andreili/STM32-PLC/TODO.txt

Hardware:
    1) Исправить разводку светодиодов RUN/STOP;
    2) Подключить сигнал CARD_DETECT к МК;
    3) Исправить посадочное место переключателя RUN/STOP;
    4)

Software:
    1) Перевести шину на аппаратный режим NSS;
    2) Переход в STOP:
        * Выставить флаг перехода в STOP;
        * Подождать завершения текущего цикла;
        * Подождать оконцания записи в NAND и SD;
        * Выставить флаг состояния STOP;
        * Ждать снятия сигнала STOP.
    3)
