andreili/STM32-PLC/(list of files, cad)

Other CAD files:
stlc/example/test.stl
stlc/example/prog.stl
