andreili/STM32-PLC/hardware/hw_cpu/hw_cpu.kicad_pcb

## KiCad design hardware/hw_cpu/hw_cpu.kicad_pcb (2017-12-27)

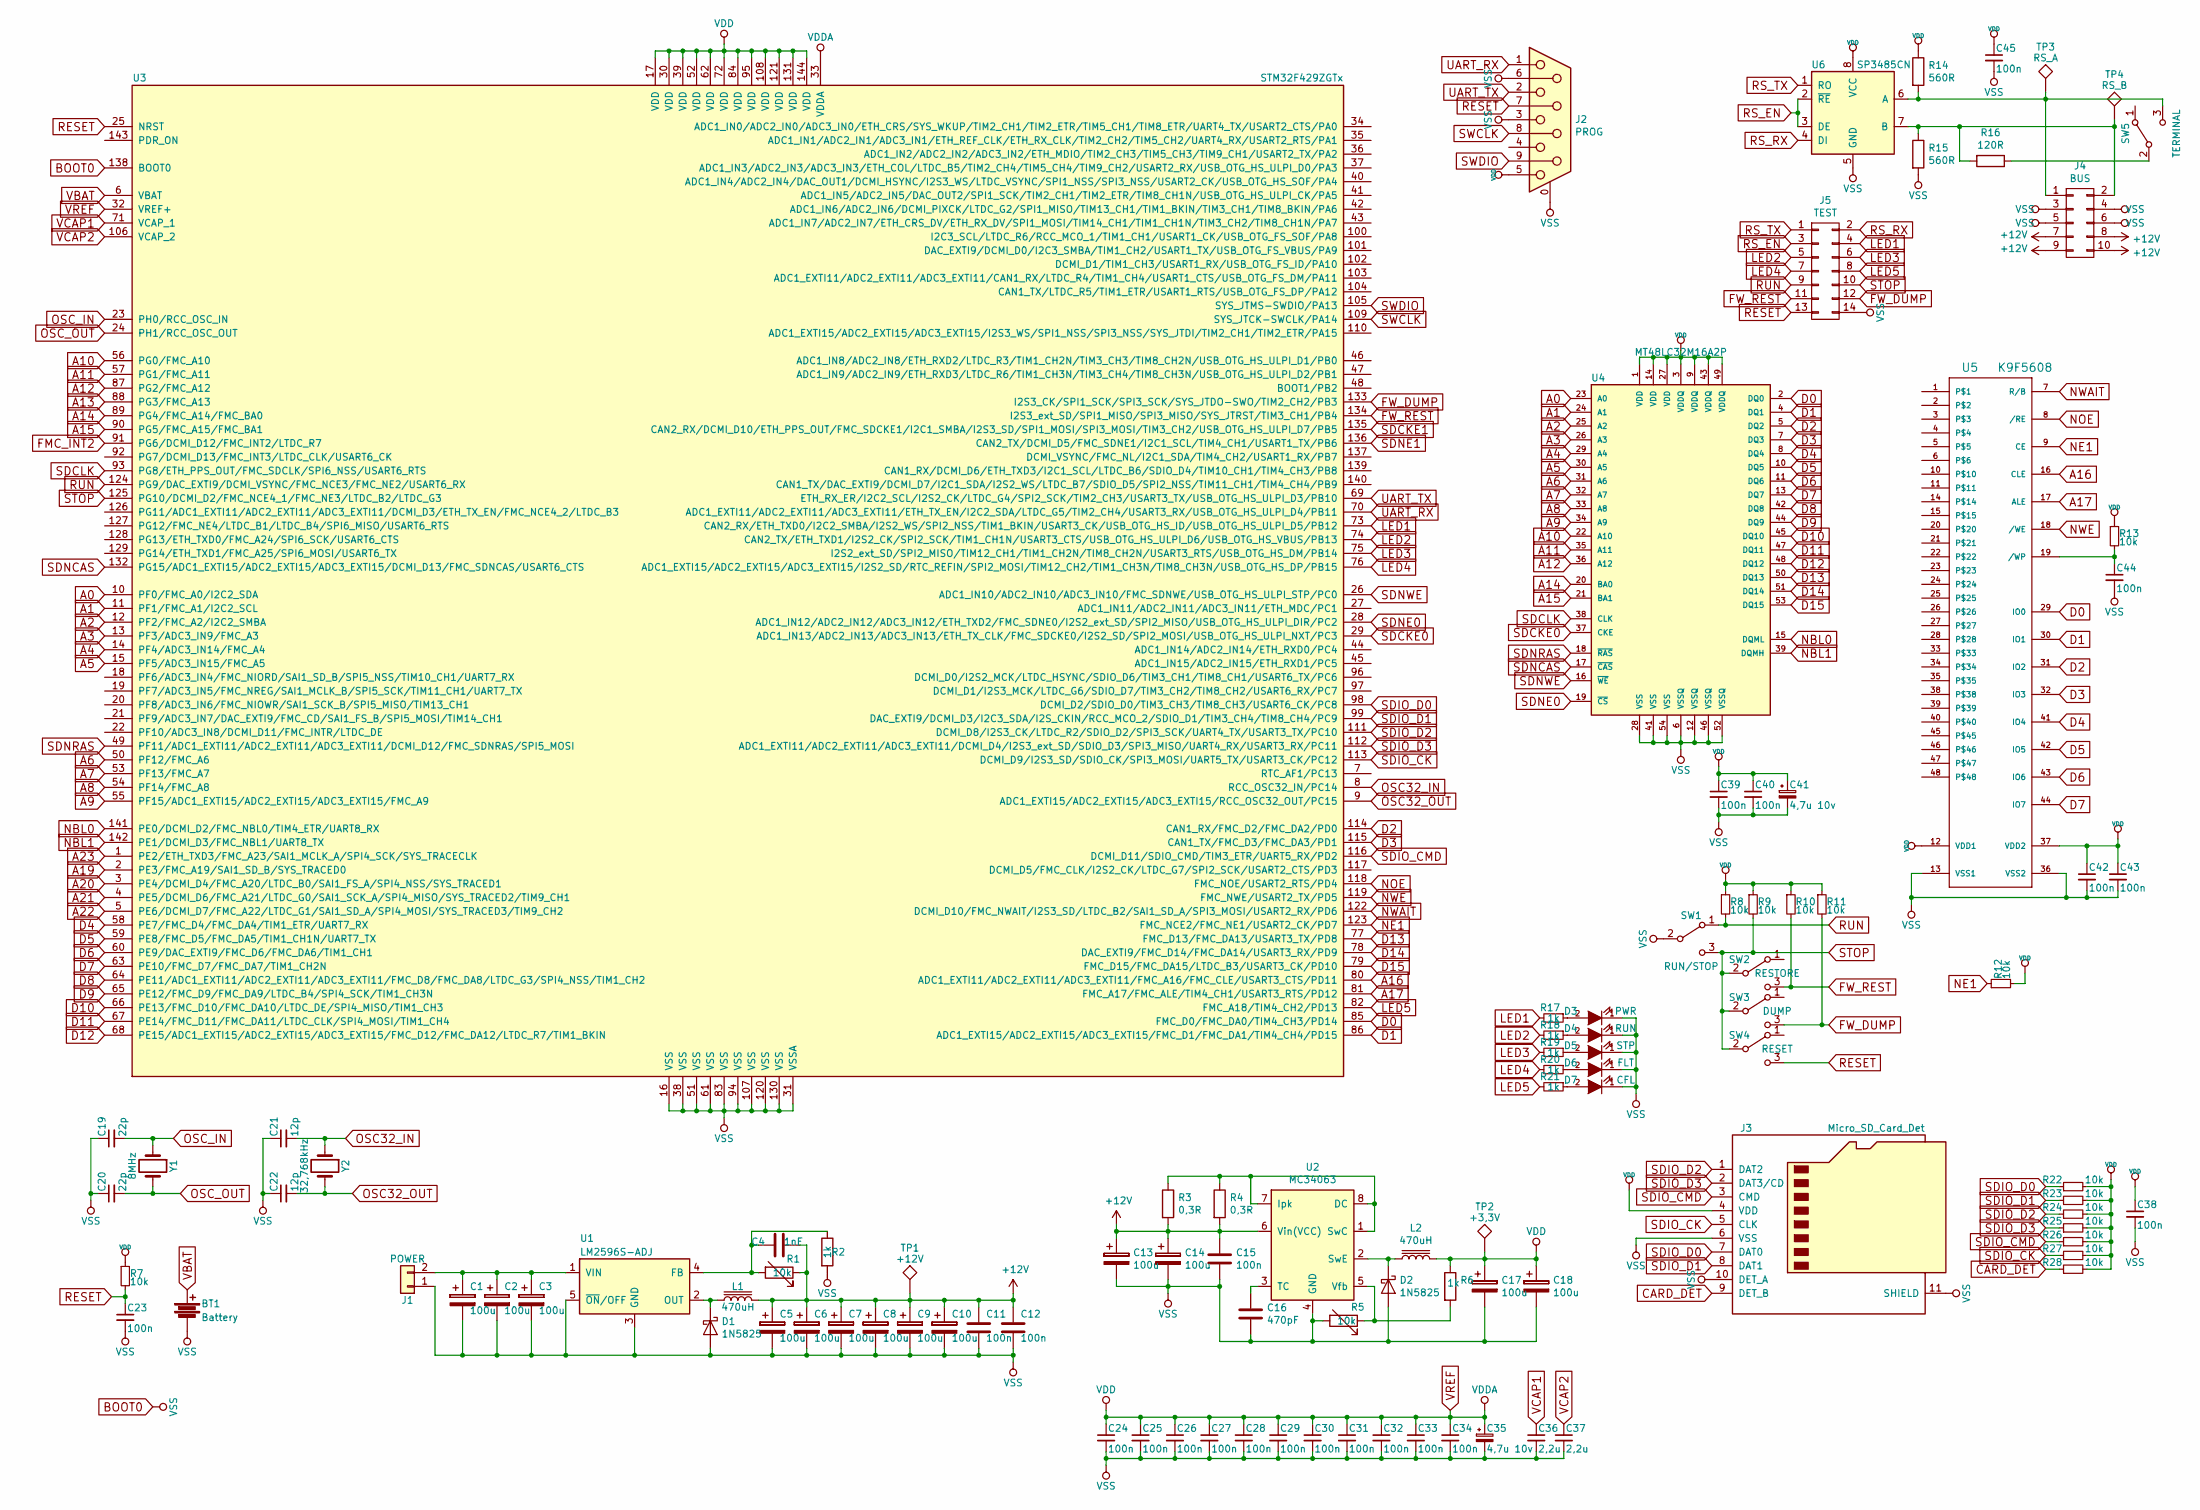
[picture p1: schematic hw_cpu.sch]

Parts:
BT1: Battery; keystone_107
C1, C2, C3, C5, C6, C7, C8, C9, C10, C13, C14, C17, C18: 100u; CP_Elec_8x6.5
C4: 1nF; C_0402
C11, C12, C15, C23, C24, C25, C26, C27, C28, C29, C30, C31, C32, C33, C34, C38, C39, C40, C42, C43, C44, C45: 100n; C_0805
C16: 470pF; C_0402
C19, C20: 22p; C_0402
C21, C22: 12p; C_0402
C35: 4,7u 10v; CP_Tantalum_Case-A_EIA-3216-18_Reflow
C36, C37: 2,2u; C_0402
C41: 4,7u 10v; CP_Tantalum_Case-B_EIA-3528-21_Reflow
D1, D2: 1N5825; D_SMA
D3: PWR; LED_0805
D4: RUN; LED_0805
D5: STP; LED_0805
D6: FLT; LED_0805
D7: CFL; LED_0805
J1: POWER; PhoenixContact_MC-G_02x3.81mm_Angled
J2: PROG; DB9FC
J3: Micro_SD_Card_Det; Conn_uSDcard
J4: BUS; he10-10d
J5: TEST; he10-14d
L1, L2: 470uH; Neosid_Inductor_SM-PIC1004H
R1, R5, R7, R8, R9, R10, R11, R12, R13, R22, R23, R24, R25, R26, R27, R28: 10k; R_0805
R2, R6, R17, R18, R19, R20, R21: 1k; R_0805
R3, R4: 0,3R; R_2010
R14, R15: 560R; R_0805
R16: 120R; R_0805
SW1: RUN/STOP; KSA_Tactile_SPST
SW2: RESTORE; SW_SPDT_PCM12
SW3: DUMP; SW_SPDT_PCM12
SW4: RESET; SW_SPDT_PCM12
SW5: TERMINAL; SW_SPDT_PCM12
TP1: +12V; Measurement_Point_Round-TH_Small
TP2: +3,3V; Measurement_Point_Round-TH_Small
TP3: RS_A; Measurement_Point_Round-TH_Small
TP4: RS_B; Measurement_Point_Round-TH_Small
U1: LM2596S-ADJ; TO-263-5_TabPin3
U2: MC34063; SOIC-8_3.9x4.9mm_Pitch1.27mm
U3: STM32F429ZGTx; LQFP-144_20x20mm_Pitch0.5mm
U4: MT48LC32M16A2P; TSOPII-54
U5: K9F5608; TSOP-I-48_12x18.4mm_Pitch0.5mm
U6: SP3485CN; SOIC-8_3.9x4.9mm_Pitch1.27mm
Y1: 8MHz; Crystal_HC49-4H_Vertical
Y2: 32,768kHz; Crystal_Round_d2.0mm_Vertical

Connections:
+12V: C4.2, C5.1, C6.1, C7.1, C8.1, C9.1, C10.1, C11.1, C12.1, C13.1, C14.1, C15.1, J4.7, J4.8, J4.9, J4.10, L1.2, R1.1, R3.2, R4.2, TP1.1, U2.6 (Vin(VCC))
A0: U3.10 (PF0/FMC_A0/I2C2_SDA), U4.23 (A0)
A1: U3.11 (PF1/FMC_A1/I2C2_SCL), U4.24 (A1)
A2: U3.12 (PF2/FMC_A2/I2C2_SMBA), U4.25 (A2)
A3: U3.13 (PF3/ADC3_IN9/FMC_A3), U4.26 (A3)
A4: U3.14 (PF4/ADC3_IN14/FMC_A4), U4.29 (A4)
A5: U3.15 (PF5/ADC3_IN15/FMC_A5), U4.30 (A5)
A6: U3.50 (PF12/FMC_A6), U4.31 (A6)
A7: U3.53 (PF13/FMC_A7), U4.32 (A7)
A8: U3.54 (PF14/FMC_A8), U4.33 (A8)
A9: U3.55 (PF15/ADC1_EXTI15/ADC2_EXTI15/ADC3_EXTI1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), U4.34 (A9)
A10: U3.56 (PG0/FMC_A10), U4.22 (A10)
A11: U3.57 (PG1/FMC_A11), U4.35 (A11)
A12: U3.87 (PG2/FMC_A12), U4.36 (A12)
A13: U3.88 (PG3/FMC_A13)
A14: U3.89 (PG4/FMC_A14/FMC_BA0), U4.20 (BA0)
A15: U3.90 (PG5/FMC_A15/FMC_BA1), U4.21 (BA1)
A16: U3.80 (ADC1_EXTI11/ADC2_EXTI11/ADC3_EXTI11/FMC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), U5.16 (CLE)
A17: U3.81 (FMC_A17/FMC_ALE/TIM4_CH1/USART3_RTS/PD12), U5.17 (ALE)
A19: U3.2 (PE3/FMC_A19/SAI1_SD_B/SYS_TRACED0)
A20: U3.3 (PE4/DCMI_D4/FMC_A20/LTDC_B0/SAI1_FS_A/S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)
A21: U3.4 (PE5/DCMI_D6/FMC_A21/LTDC_G0/SAI1_SCK_A/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)
A22: U3.5 (PE6/DCMI_D7/FMC_A22/LTDC_G1/SAI1_SD_A/S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)
A23: U3.1 (PE2/ETH_TXD3/FMC_A23/SAI1_MCLK_A/SPI4_S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)
BOOT0: BT1.2, C1.2, C2.2, C3.2, C5.2, C6.2, C7.2, C8.2, C9.2, C10.2, C11.2, C12.2, C13.2, C14.2, C15.2, C16.2, C17.2, C18.2, C19.1, C20.1, C21.1, C22.1, C23.2, C24.2, C25.2, C26.2, C27.2, C28.2, C29.2, C30.2, C31.2, C32.2, C33.2, C34.2, C35.2, C36.2, C37.2, C38.2, C39.2, C40.2, C41.2, C42.2, C43.2, C44.2, C45.2, D1.2 (A), D2.2 (A), D3.1 (K), D4.1 (K), D5.1 (K), D6.1 (K), D7.1 (K), J1.1, J2.0 (PAD), J2.3, J2.6, J3.6 (VSS), J3.10 (DET_A), J3.11 (SHIELD), J4.3, J4.4, J4.5, J4.6, J5.14, R2.2, R5.2, R15.2, SW1.2 (B), U1.3 (GND), U1.5 (~ON~/OFF), U2.4 (GND), U3.16 (VSS), U3.31 (VSSA), U3.38 (VSS), U3.51 (VSS), U3.61 (VSS), U3.83 (VSS), U3.94 (VSS), U3.107 (VSS), U3.120 (VSS), U3.130 (VSS), U3.138 (BOOT0), U4.6 (VSSQ), U4.12 (VSSQ), U4.28 (VSS), U4.41 (VSS), U4.46 (VSSQ), U4.52 (VSSQ), U4.54 (VSS), U5.13 (VSS1), U5.36 (VSS2), U6.5 (GND)
CARD_DET: J3.9 (DET_B), R28.1
D0: U3.85 (FMC_D0/FMC_DA0/TIM4_CH3/PD14), U4.2 (DQ0), U5.29 (IO0)
D1: U3.86 (ADC1_EXTI15/ADC2_EXTI15/ADC3_EXTI15/FMC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), U4.4 (DQ1), U5.30 (IO1)
D2: U3.114 (CAN1_RX/FMC_D2/FMC_DA2/PD0), U4.5 (DQ2), U5.31 (IO2)
D3: U3.115 (CAN1_TX/FMC_D3/FMC_DA3/PD1), U4.7 (DQ3), U5.32 (IO3)
D4: U3.58 (PE7/FMC_D4/FMC_DA4/TIM1_ETR/UART7_RX), U4.8 (DQ4), U5.41 (IO4)
D5: U3.59 (PE8/FMC_D5/FMC_DA5/TIM1_CH1N/UART7_TX), U4.10 (DQ5), U5.42 (IO5)
D6: U3.60 (PE9/DAC_EXTI9/FMC_D6/FMC_DA6/TIM1_CH1), U4.11 (DQ6), U5.43 (IO6)
D7: U3.63 (PE10/FMC_D7/FMC_DA7/TIM1_CH2N), U4.13 (DQ7), U5.44 (IO7)
D8: U3.64 (PE11/ADC1_EXTI11/ADC2_EXTI11/ADC3_EXTI1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), U4.42 (DQ8)
D9: U3.65 (PE12/FMC_D9/FMC_DA9/LTDC_B4/SPI4_SCK/TI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), U4.44 (DQ9)
D10: U3.66 (PE13/FMC_D10/FMC_DA10/LTDC_DE/SPI4_MISO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), U4.45 (DQ10)
D11: U3.67 (PE14/FMC_D11/FMC_DA11/LTDC_CLK/SPI4_MOS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), U4.47 (DQ11)
D12: U3.68 (PE15/ADC1_EXTI15/ADC2_EXTI15/ADC3_EXTI1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), U4.48 (DQ12)
D13: U3.77 (FMC_D13/FMC_DA13/USART3_TX/PD8), U4.50 (DQ13)
D14: U3.78 (DAC_EXTI9/FMC_D14/FMC_DA14/USART3_RX/PD9), U4.51 (DQ14)
D15: U3.79 (FMC_D15/FMC_DA15/LTDC_B3/USART3_CK/PD10), U4.53 (DQ15)
FMC_INT2: U3.91 (PG6/DCMI_D12/FMC_INT2/LTDC_R7)
FW_DUMP: J5.12, R11.2, SW3.3 (C), U3.133 (I2S3_CK/SPI1_SCK/SPI3_SCK/SYS_JTDO-SWO/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)
FW_REST: J5.11, R10.2, SW2.3 (C), U3.134 (I2S3_ext_SD/SPI1_MISO/SPI3_MISO/SYS_JTR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)
LED1: J5.4, R17.2, U3.73 (CAN2_RX/ETH_TXD0/I2C2_SMBA/I2S2_WS/SPI2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)
LED2: J5.5, R18.2, U3.74 (CAN2_TX/ETH_TXD1/I2S2_CK/SPI2_SCK/TIM1_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)
LED3: J5.6, R19.2, U3.75 (I2S2_ext_SD/SPI2_MISO/TIM12_CH1/TIM1_CH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)
LED4: J5.7, R20.2, U3.76 (ADC1_EXTI15/ADC2_EXTI15/ADC3_EXTI15/I2S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)
LED5: J5.8, R21.2, U3.82 (FMC_A18/TIM4_CH2/PD13)
NBL0: U3.141 (PE0/DCMI_D2/FMC_NBL0/TIM4_ETR/UART8_RX), U4.15 (DQML)
NBL1: U3.142 (PE1/DCMI_D3/FMC_NBL1/UART8_TX), U4.39 (DQMH)
NE1: R12.1, U3.123 (FMC_NCE2/FMC_NE1/USART2_CK/PD7), U5.9 (CE)
NOE: U3.118 (FMC_NOE/USART2_RTS/PD4), U5.8 (/RE)
NWAIT: U3.122 (DCMI_D10/FMC_NWAIT/I2S3_SD/LTDC_B2/SAI1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), U5.7 (R/B)
NWE: U3.119 (FMC_NWE/USART2_TX/PD5), U5.18 (/WE)
unnamed: C1.1, C2.1, C3.1, J1.2, U1.1 (VIN)
unnamed: C4.1, R1.2, R2.1, U1.4 (FB)
unnamed: C16.1, U2.3 (TC)
unnamed: C44.1, R13.2, U5.19 (/WP)
unnamed: D1.1 (K), L1.1, U1.2 (OUT)
unnamed: D2.1 (K), L2.1, U2.2 (SwE)
unnamed: D3.2 (A), R17.1
unnamed: D4.2 (A), R18.1
unnamed: D5.2 (A), R19.1
unnamed: D6.2 (A), R20.1
unnamed: D7.2 (A), R21.1
unnamed: J4.1, R14.2, SW5.3 (C), TP3.1, U6.6 (A)
unnamed: J4.2, R15.1, R16.2, TP4.1, U6.7 (B)
unnamed: R3.1, R4.1, U2.1 (SwC), U2.7 (Ipk), U2.8 (DC)
unnamed: R5.1, R6.2, U2.5 (Vfb)
unnamed: R16.1, SW5.2 (B)
OSC32_IN: C21.2, U3.8 (RCC_OSC32_IN/PC14), Y2.1
OSC32_OUT: C22.2, U3.9 (ADC1_EXTI15/ADC2_EXTI15/ADC3_EXTI15/RCC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), Y2.2
OSC_IN: C19.2, U3.23 (PH0/RCC_OSC_IN), Y1.1
OSC_OUT: C20.2, U3.24 (PH1/RCC_OSC_OUT), Y1.2
RESET: C23.1, J2.7, J5.13, R7.2, SW4.3 (C), U3.25 (NRST)
RS_EN: J5.3, U6.2 (~RE~), U6.3 (DE)
RS_RX: J5.2, U6.4 (DI)
RS_TX: J5.1, U6.1 (RO)
RUN: J5.9, R8.2, SW1.1 (A), U3.124 (PG9/DAC_EXTI9/DCMI_VSYNC/FMC_NCE3/FMC_N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)
SDCKE0: U3.29 (ADC1_IN13/ADC2_IN13/ADC3_IN13/ETH_TX_CL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), U4.37 (CKE)
SDCKE1: U3.135 (CAN2_RX/DCMI_D10/ETH_PPS_OUT/FMC_SDCKE1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)
SDCLK: U3.93 (PG8/ETH_PPS_OUT/FMC_SDCLK/SPI6_NSS/USAR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), U4.38 (CLK)
SDIO_CK: J3.5 (CLK), R27.1, U3.113 (DCMI_D9/I2S3_SD/SDIO_CK/SPI3_MOSI/UART5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)
SDIO_CMD: J3.3 (CMD), R26.1, U3.116 (DCMI_D11/SDIO_CMD/TIM3_ETR/UART5_RX/PD2)
SDIO_D0: J3.7 (DAT0), R22.1, U3.98 (DCMI_D2/SDIO_D0/TIM3_CH3/TIM8_CH3/USART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)
SDIO_D1: J3.8 (DAT1), R23.1, U3.99 (DAC_EXTI9/DCMI_D3/I2C3_SDA/I2S_CKIN/RCC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)
SDIO_D2: J3.1 (DAT2), R24.1, U3.111 (DCMI_D8/I2S3_CK/LTDC_R2/SDIO_D2/SPI3_SC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)
SDIO_D3: J3.2 (DAT3/CD), R25.1, U3.112 (ADC1_EXTI11/ADC2_EXTI11/ADC3_EXTI11/DCM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)
SDNCAS: U3.132 (PG15/ADC1_EXTI15/ADC2_EXTI15/ADC3_EXTI1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), U4.17 (~CAS~)
SDNE0: U3.28 (ADC1_IN12/ADC2_IN12/ADC3_IN12/ETH_TXD2/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), U4.19 (~CS~)
SDNE1: U3.136 (CAN2_TX/DCMI_D5/FMC_SDNE1/I2C1_SCL/TIM4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)
SDNRAS: U3.49 (PF11/ADC1_EXTI11/ADC2_EXTI11/ADC3_EXTI1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), U4.18 (~RAS~)
SDNWE: U3.26 (ADC1_IN10/ADC2_IN10/ADC3_IN10/FMC_SDNWE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), U4.16 (~WE~)
STOP: J5.10, R9.2, SW1.3 (C), SW2.2 (B), SW3.2 (B), SW4.2 (B), U3.125 (PG10/DCMI_D2/FMC_NCE4_1/FMC_NE3/LTDC_B2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)
SWCLK: J2.8, U3.109 (SYS_JTCK-SWCLK/PA14)
SWDIO: J2.9, U3.105 (SYS_JTMS-SWDIO/PA13)
UART_RX: J2.1, U3.70 (ADC1_EXTI11/ADC2_EXTI11/ADC3_EXTI11/ETH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)
UART_TX: J2.2, U3.69 (ETH_RX_ER/I2C2_SCL/I2S2_CK/LTDC_G4/SPI2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)
VBAT: BT1.1, U3.6 (VBAT)
VCAP1: C36.1, U3.71 (VCAP_1)
VCAP2: C37.1, U3.106 (VCAP_2)
VREF: C17.1, C18.1, C24.1, C25.1, C26.1, C27.1, C28.1, C29.1, C30.1, C31.1, C32.1, C33.1, C34.1, C35.1, C38.1, C39.1, C40.1, C41.1, C42.1, C43.1, C45.1, J2.5, J3.4 (VDD), L2.2, R6.1, R7.1, R8.1, R9.1, R10.1, R11.1, R12.2, R13.1, R14.1, R22.2, R23.2, R24.2, R25.2, R26.2, R27.2, R28.2, TP2.1, U3.17 (VDD), U3.30 (VDD), U3.32 (VREF+), U3.33 (VDDA), U3.39 (VDD), U3.52 (VDD), U3.62 (VDD), U3.72 (VDD), U3.84 (VDD), U3.95 (VDD), U3.108 (VDD), U3.121 (VDD), U3.131 (VDD), U3.144 (VDD), U4.1 (VDD), U4.3 (VDDQ), U4.9 (VDDQ), U4.14 (VDD), U4.27 (VDD), U4.43 (VDDQ), U4.49 (VDDQ), U5.12 (VDD1), U5.37 (VDD2), U6.8 (VCC)

Board: 2 copper layers, 104 parts (2 on the bottom side), 91 nets, no tracks yet.
