andreili/STM32-PLC/hardware/hw_do16/module_do.kicad_pcb

## KiCad design hardware/hw_do16/module_do.kicad_pcb (2017-09-01)

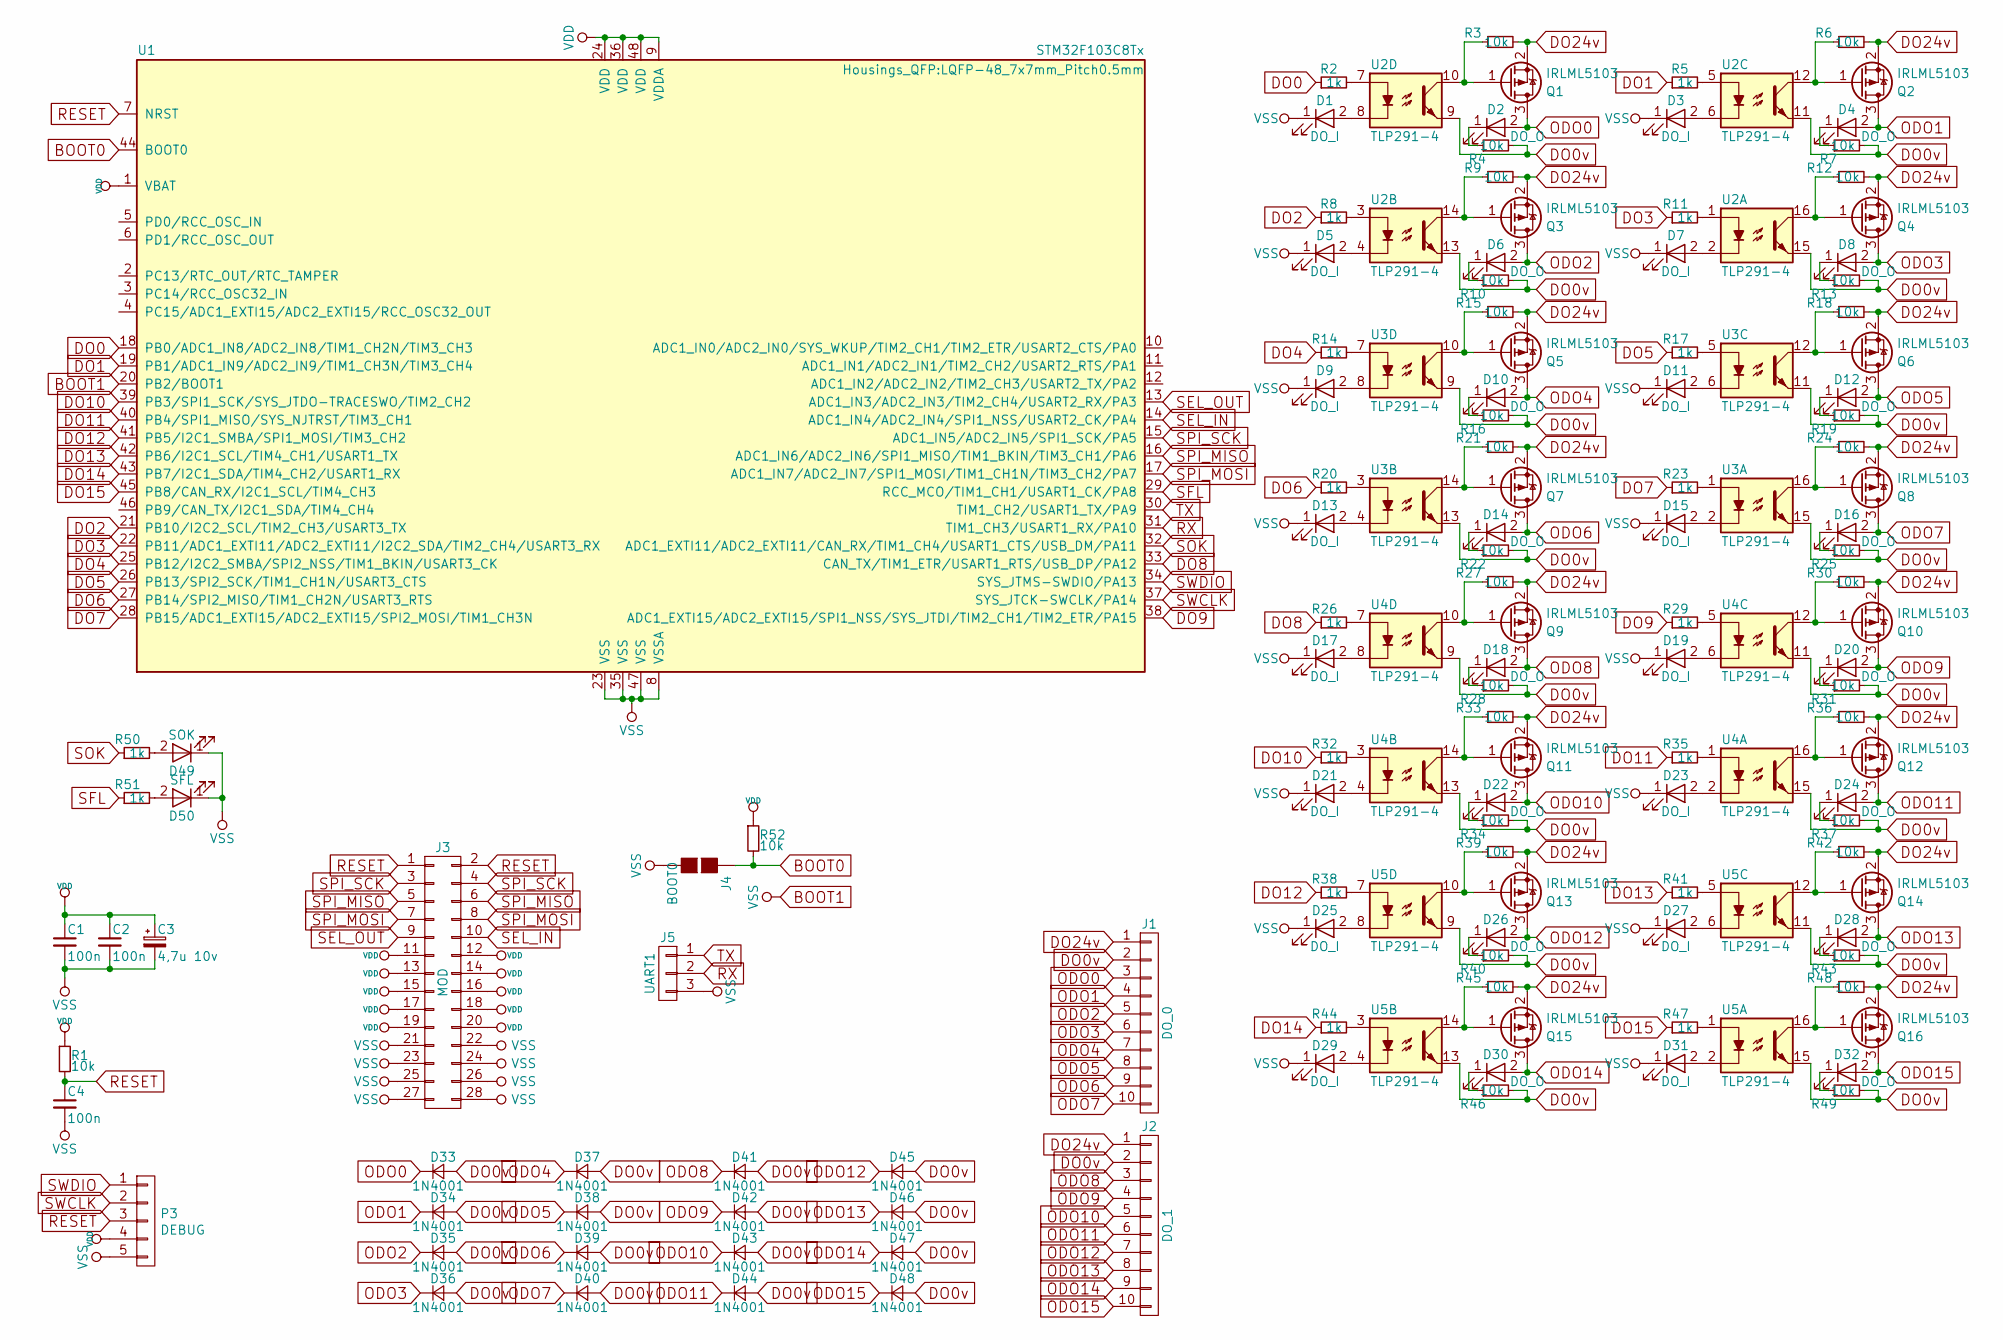
[picture p2: schematic module_do.sch]

Parts:
C1, C2, C4: 100n; C_0805
C3: 4,7u 10v; CP_Tantalum_Case-A_EIA-3216-18_Wave
D1, D3, D5, D7, D9, D11, D13, D15, D17, D19, D21, D23, D25, D27, D29, D31: DO_I; LED_0603
D2, D4, D6, D8, D10, D12, D14, D16, D18, D20, D22, D24, D26, D28, D30, D32: DO_O; LED_0603
D33, D34, D35, D36, D37, D38, D39, D40, D41, D42, D43, D44, D45, D46, D47, D48: 1N4001; D_SOD-123
D49: SOK; LED_0603
D50: SFL; LED_0603
J1: DO_0; PhoenixContact_MC-G_10x3.81mm_Angled
J2: DO_1; PhoenixContact_MC-G_10x3.81mm_Angled
J3: MOD; Pin_Header_2.00mm_SMD
J4: BOOT0; GS2
J5: UART1; Pin_Header_Straight_1x03_Pitch2.00mm
P3: DEBUG; Socket_Strip_Straight_1x05_Pitch2.00mm
Q1, Q2, Q3, Q4, Q5, Q6, Q7, Q8, Q9, Q10, Q11, Q12, Q13, Q14, Q15, Q16: IRLML5103; SOT-23
R1, R3, R4, R6, R7, R9, R10, R12, R13, R15, R16, R18, R19, R21, R22, R24, R25, R27, R28, R30, R31, R33, R34, R36, R37, R39, R40, R42, R43, R45, R46, R48, R49, R52: 10k; R_0805
R2, R5, R8, R11, R14, R17, R20, R23, R26, R29, R32, R35, R38, R41, R44, R47, R50, R51: 1k; R_0805
U1: STM32F103C8Tx; LQFP-48_7x7mm_Pitch0.5mm
U2, U3, U4, U5: TLP291-4; SO-16-N

Connections:
BOOT0: J4.1 (G1), R52.2, U1.44 (BOOT0)
BOOT1: C1.2, C2.2, C3.2, C4.2, D1.1 (K), D3.1 (K), D5.1 (K), D7.1 (K), D9.1 (K), D11.1 (K), D13.1 (K), D15.1 (K), D17.1 (K), D19.1 (K), D21.1 (K), D23.1 (K), D25.1 (K), D27.1 (K), D29.1 (K), D31.1 (K), D49.1 (K), D50.1 (K), J3.21, J3.22, J3.23, J3.24, J3.25, J3.26, J3.27, J3.28, J4.2 (G2), J5.3, P3.5, U1.8 (VSSA), U1.20 (PB2/BOOT1), U1.23 (VSS), U1.35 (VSS), U1.47 (VSS)
DO0: R2.1, U1.18 (PB0/ADC1_IN8/ADC2_IN8/TIM1_CH2N/TIM3_CH3)
DO0v: D33.2 (A), D34.2 (A), D35.2 (A), D36.2 (A), D37.2 (A), D38.2 (A), D39.2 (A), D40.2 (A), D41.2 (A), D42.2 (A), D43.2 (A), D44.2 (A), D45.2 (A), D46.2 (A), D47.2 (A), D48.2 (A), J1.2, J2.2, R4.2, R7.2, R10.2, R13.2, R16.2, R19.2, R22.2, R25.2, R28.2, R31.2, R34.2, R37.2, R40.2, R43.2, R46.2, R49.2, U2.9, U2.11, U2.13, U2.15, U3.9, U3.11, U3.13, U3.15, U4.9, U4.11, U4.13, U4.15, U5.9, U5.11, U5.13, U5.15
DO1: R5.1, U1.19 (PB1/ADC1_IN9/ADC2_IN9/TIM1_CH3N/TIM3_CH4)
DO2: R8.1, U1.21 (PB10/I2C2_SCL/TIM2_CH3/USART3_TX)
DO3: R11.1, U1.22 (PB11/ADC1_EXTI11/ADC2_EXTI11/I2C2_SDA/T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)
DO4: R14.1, U1.25 (PB12/I2C2_SMBA/SPI2_NSS/TIM1_BKIN/USART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)
DO5: R17.1, U1.26 (PB13/SPI2_SCK/TIM1_CH1N/USART3_CTS)
DO6: R20.1, U1.27 (PB14/SPI2_MISO/TIM1_CH2N/USART3_RTS)
DO7: R23.1, U1.28 (PB15/ADC1_EXTI15/ADC2_EXTI15/SPI2_MOSI/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)
DO8: R26.1, U1.33 (CAN_TX/TIM1_ETR/USART1_RTS/USB_DP/PA12)
DO9: R29.1, U1.38 (ADC1_EXTI15/ADC2_EXTI15/SPI1_NSS/SYS_JT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)
DO10: R32.1, U1.39 (PB3/SPI1_SCK/SYS_JTDO-TRACESWO/TIM2_CH2)
DO11: R35.1, U1.40 (PB4/SPI1_MISO/SYS_NJTRST/TIM3_CH1)
DO12: R38.1, U1.41 (PB5/I2C1_SMBA/SPI1_MOSI/TIM3_CH2)
DO13: R41.1, U1.42 (PB6/I2C1_SCL/TIM4_CH1/USART1_TX)
DO14: R44.1, U1.43 (PB7/I2C1_SDA/TIM4_CH2/USART1_RX)
DO15: R47.1, U1.45 (PB8/CAN_RX/I2C1_SCL/TIM4_CH3)
DO24v: J1.1, J2.1, Q1.2 (S), Q2.2 (S), Q3.2 (S), Q4.2 (S), Q5.2 (S), Q6.2 (S), Q7.2 (S), Q8.2 (S), Q9.2 (S), Q10.2 (S), Q11.2 (S), Q12.2 (S), Q13.2 (S), Q14.2 (S), Q15.2 (S), Q16.2 (S), R3.2, R6.2, R9.2, R12.2, R15.2, R18.2, R21.2, R24.2, R27.2, R30.2, R33.2, R36.2, R39.2, R42.2, R45.2, R48.2
unnamed: D1.2 (A), U2.8
unnamed: D2.1 (K), R4.1
unnamed: D3.2 (A), U2.6
unnamed: D4.1 (K), R7.1
unnamed: D5.2 (A), U2.4
unnamed: D6.1 (K), R10.1
unnamed: D7.2 (A), U2.2
unnamed: D8.1 (K), R13.1
unnamed: D9.2 (A), U3.8
unnamed: D10.1 (K), R16.1
unnamed: D11.2 (A), U3.6
unnamed: D12.1 (K), R19.1
unnamed: D13.2 (A), U3.4
unnamed: D14.1 (K), R22.1
unnamed: D15.2 (A), U3.2
unnamed: D16.1 (K), R25.1
unnamed: D17.2 (A), U4.8
unnamed: D18.1 (K), R28.1
unnamed: D19.2 (A), U4.6
unnamed: D20.1 (K), R31.1
unnamed: D21.2 (A), U4.4
unnamed: D22.1 (K), R34.1
unnamed: D23.2 (A), U4.2
unnamed: D24.1 (K), R37.1
unnamed: D25.2 (A), U5.8
unnamed: D26.1 (K), R40.1
unnamed: D27.2 (A), U5.6
unnamed: D28.1 (K), R43.1
unnamed: D29.2 (A), U5.4
unnamed: D30.1 (K), R46.1
unnamed: D31.2 (A), U5.2
unnamed: D32.1 (K), R49.1
unnamed: D49.2 (A), R50.2
unnamed: D50.2 (A), R51.2
unnamed: Q1.1 (G), R3.1, U2.10
unnamed: Q2.1 (G), R6.1, U2.12
unnamed: Q3.1 (G), R9.1, U2.14
unnamed: Q4.1 (G), R12.1, U2.16
unnamed: Q5.1 (G), R15.1, U3.10
unnamed: Q6.1 (G), R18.1, U3.12
unnamed: Q7.1 (G), R21.1, U3.14
unnamed: Q8.1 (G), R24.1, U3.16
unnamed: Q9.1 (G), R27.1, U4.10
unnamed: Q10.1 (G), R30.1, U4.12
unnamed: Q11.1 (G), R33.1, U4.14
unnamed: Q12.1 (G), R36.1, U4.16
unnamed: Q13.1 (G), R39.1, U5.10
unnamed: Q14.1 (G), R42.1, U5.12
unnamed: Q15.1 (G), R45.1, U5.14
unnamed: Q16.1 (G), R48.1, U5.16
unnamed: R2.2, U2.7
unnamed: R5.2, U2.5
unnamed: R8.2, U2.3
unnamed: R11.2, U2.1
unnamed: R14.2, U3.7
unnamed: R17.2, U3.5
unnamed: R20.2, U3.3
unnamed: R23.2, U3.1
unnamed: R26.2, U4.7
unnamed: R29.2, U4.5
unnamed: R32.2, U4.3
unnamed: R35.2, U4.1
unnamed: R38.2, U5.7
unnamed: R41.2, U5.5
unnamed: R44.2, U5.3
unnamed: R47.2, U5.1
ODO0: D2.2 (A), D33.1 (K), J1.3, Q1.3 (D)
ODO1: D4.2 (A), D34.1 (K), J1.4, Q2.3 (D)
ODO2: D6.2 (A), D35.1 (K), J1.5, Q3.3 (D)
ODO3: D8.2 (A), D36.1 (K), J1.6, Q4.3 (D)
ODO4: D10.2 (A), D37.1 (K), J1.7, Q5.3 (D)
ODO5: D12.2 (A), D38.1 (K), J1.8, Q6.3 (D)
ODO6: D14.2 (A), D39.1 (K), J1.9, Q7.3 (D)
ODO7: D16.2 (A), D40.1 (K), J1.10, Q8.3 (D)
ODO8: D18.2 (A), D41.1 (K), J2.3, Q9.3 (D)
ODO9: D20.2 (A), D42.1 (K), J2.4, Q10.3 (D)
ODO10: D22.2 (A), D43.1 (K), J2.5, Q11.3 (D)
ODO11: D24.2 (A), D44.1 (K), J2.6, Q12.3 (D)
ODO12: D26.2 (A), D45.1 (K), J2.7, Q13.3 (D)
ODO13: D28.2 (A), D46.1 (K), J2.8, Q14.3 (D)
ODO14: D30.2 (A), D47.1 (K), J2.9, Q15.3 (D)
ODO15: D32.2 (A), D48.1 (K), J2.10, Q16.3 (D)
RESET: C4.1, J3.1, J3.2, P3.3, R1.2, U1.7 (NRST)
RX: J5.2, U1.31 (TIM1_CH3/USART1_RX/PA10)
SEL_IN: J3.10, U1.14 (ADC1_IN4/ADC2_IN4/SPI1_NSS/USART2_CK/PA4)
SEL_OUT: J3.9, U1.13 (ADC1_IN3/ADC2_IN3/TIM2_CH4/USART2_RX/PA3)
SFL: R51.1, U1.29 (RCC_MCO/TIM1_CH1/USART1_CK/PA8)
SOK: R50.1, U1.32 (ADC1_EXTI11/ADC2_EXTI11/CAN_RX/TIM1_CH4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)
SPI_MISO: J3.5, J3.6, U1.16 (ADC1_IN6/ADC2_IN6/SPI1_MISO/TIM1_BKIN/T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)
SPI_MOSI: J3.7, J3.8, U1.17 (ADC1_IN7/ADC2_IN7/SPI1_MOSI/TIM1_CH1N/T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)
SPI_SCK: J3.3, J3.4, U1.15 (ADC1_IN5/ADC2_IN5/SPI1_SCK/PA5)
SWCLK: P3.2, U1.37 (SYS_JTCK-SWCLK/PA14)
SWDIO: P3.1, U1.34 (SYS_JTMS-SWDIO/PA13)
TX: J5.1, U1.30 (TIM1_CH2/USART1_TX/PA9)
VDD: C1.1, C2.1, C3.1, J3.11, J3.12, J3.13, J3.14, J3.15, J3.16, J3.17, J3.18, J3.19, J3.20, P3.4, R1.1, R52.1, U1.1 (VBAT), U1.9 (VDDA), U1.24 (VDD), U1.36 (VDD), U1.48 (VDD)

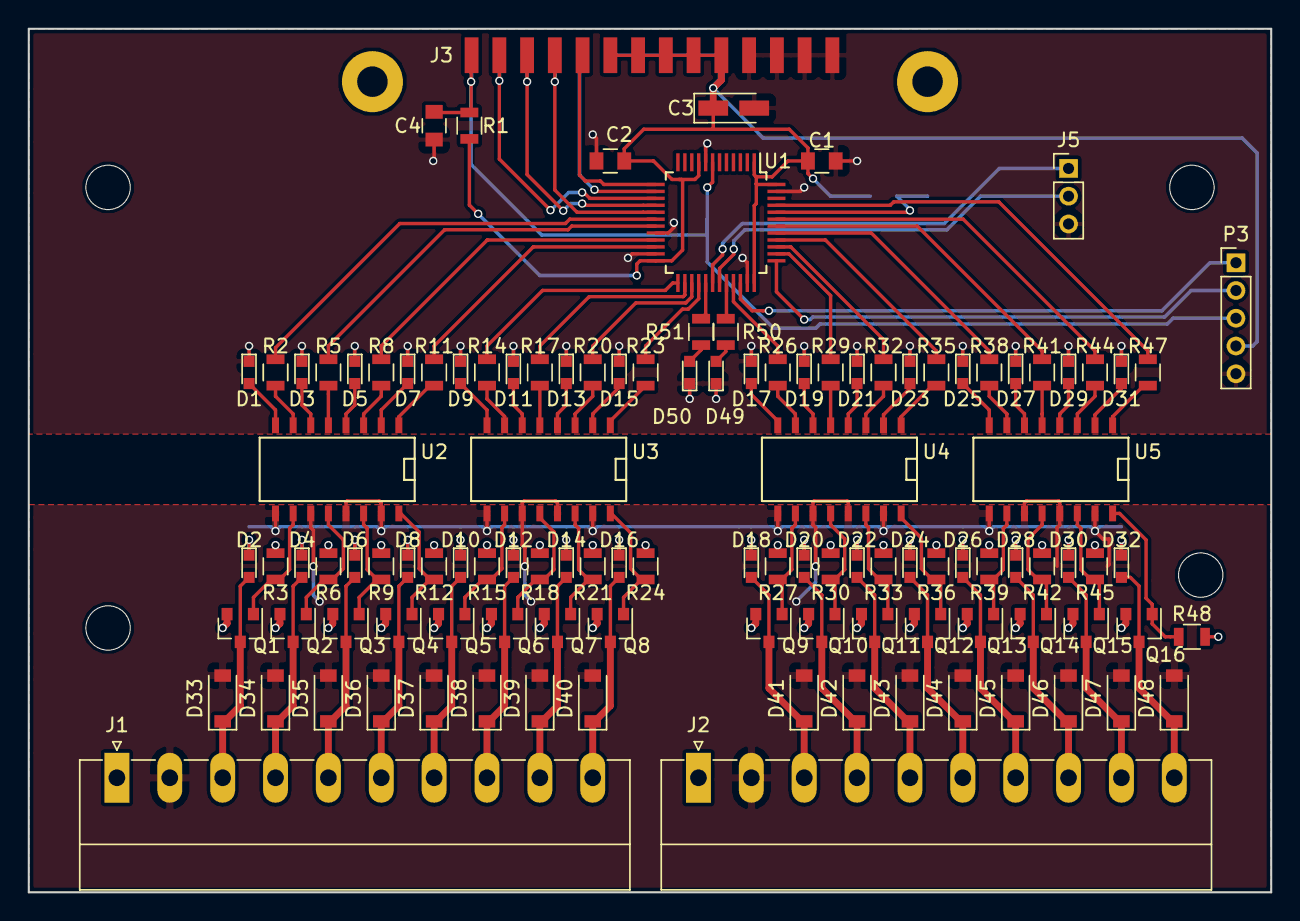
[picture p3: board module_do.kicad_pcb from above]

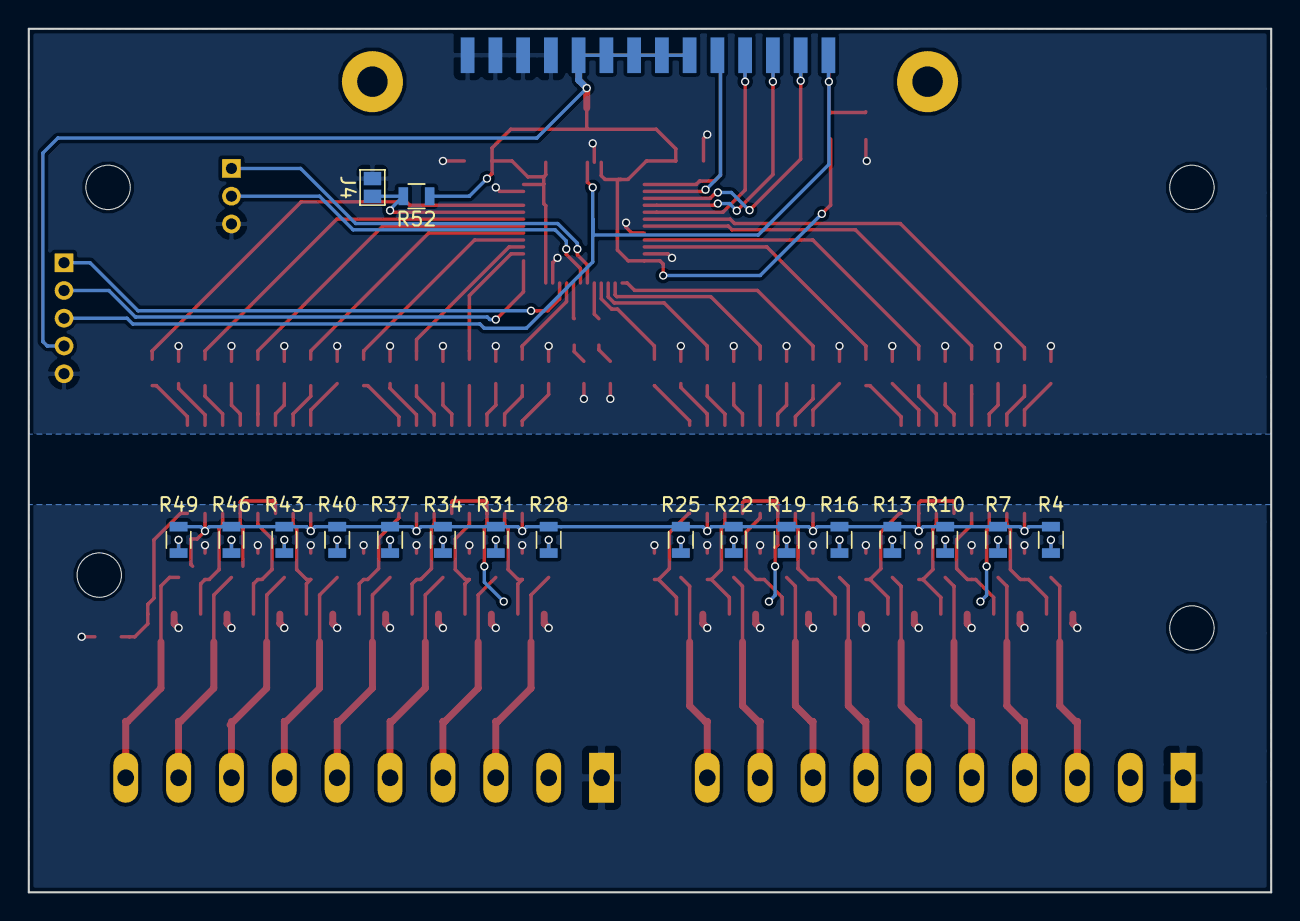
[picture p4: board module_do.kicad_pcb from below]

Board: 2 copper layers, 89.5 x 62.2 mm, 133 parts (18 on the bottom side), 115 nets.
