andreili/STM32-PLC/hardware/hw_di16/module_di.kicad_pcb

## KiCad design hardware/hw_di16/module_di.kicad_pcb (2017-09-01)

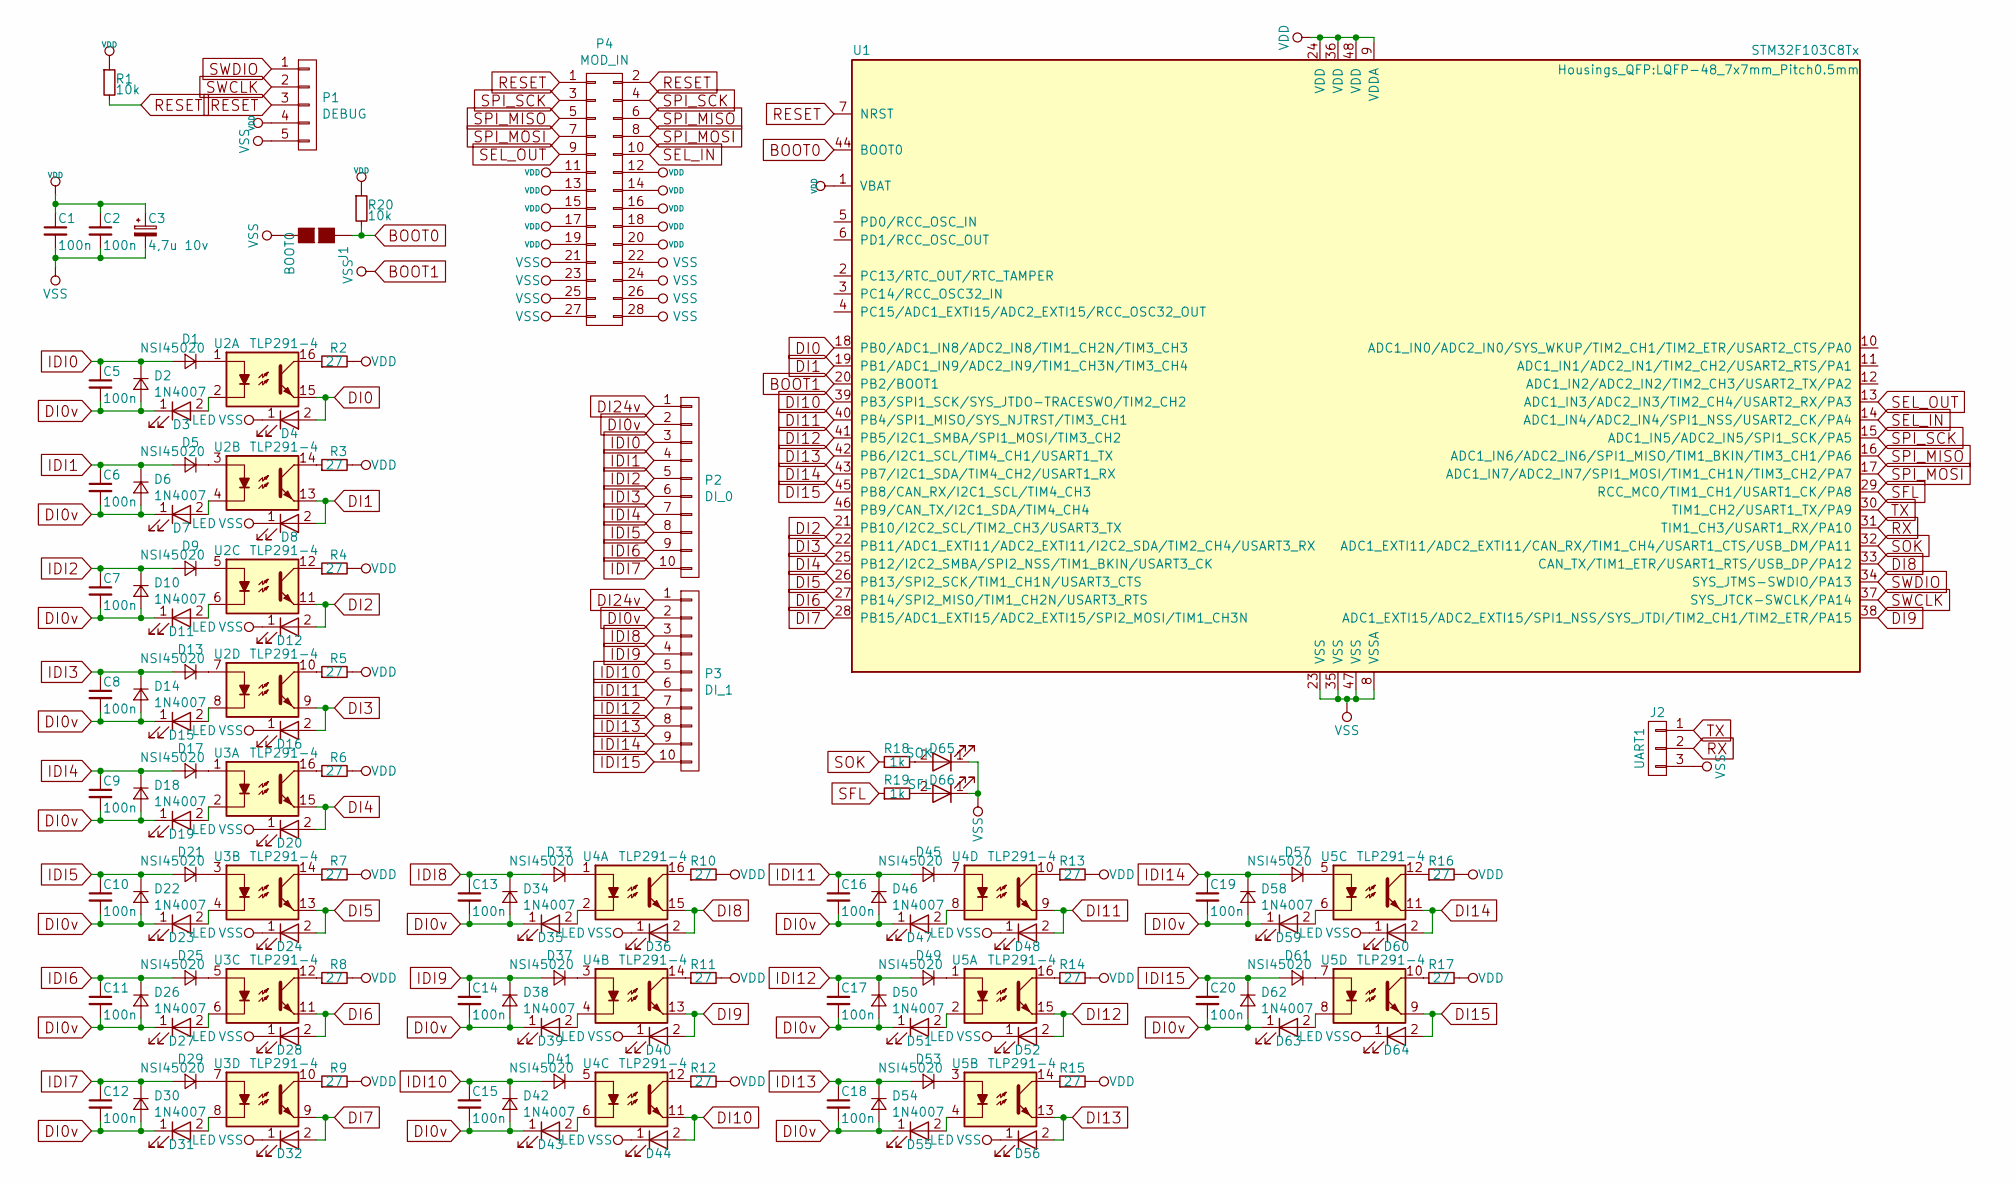
[picture p5: schematic module_di.sch]

Parts:
C1, C2, C5, C6, C7, C8, C9, C10, C11, C12, C13, C14, C15, C16, C17, C18, C19, C20: 100n; C_0805
C3: 4,7u 10v; CP_Tantalum_Case-A_EIA-3216-18_Reflow
D1, D5, D9, D13, D17, D21, D25, D29, D33, D37, D41, D45, D49, D53, D57, D61: NSI45020; D_SOD-123
D2, D6, D10, D14, D18, D22, D26, D30, D34, D38, D42, D46, D50, D54, D58, D62: 1N4007; D_SOD-123
D3, D4, D7, D8, D11, D12, D15, D16, D19, D20, D23, D24, D27, D28, D31, D32, D35, D36, D39, D40, D43, D44, D47, D48, D51, D52, D55, D56, D59, D60, D63, D64: LED; LED_0603
D65: SOK; LED_0603
D66: SFL; LED_0603
J1: BOOT0; GS2
J2: UART1; Pin_Header_Straight_1x03_Pitch2.00mm
P1: DEBUG; Pin_Header_Straight_1x05_Pitch2.00mm
P2: DI_0; PhoenixContact_MC-G_10x3.81mm_Angled
P3: DI_1; PhoenixContact_MC-G_10x3.81mm_Angled
P4: MOD_IN; Pin_Header_2.00mm_SMD
R1, R20: 10k; R_0805
R2, R3, R4, R5, R6, R7, R8, R9, R10, R11, R12, R13, R14, R15, R16, R17: 27; R_0805
R18, R19: 1k; R_0805
U1: STM32F103C8Tx; LQFP-48_7x7mm_Pitch0.5mm
U2, U3, U4, U5: TLP291-4; SO-16-N

Connections:
BOOT0: J1.1 (G1), R20.2, U1.44 (BOOT0)
BOOT1: C1.2, C2.2, C3.2, D4.1 (K), D8.1 (K), D12.1 (K), D16.1 (K), D20.1 (K), D24.1 (K), D28.1 (K), D32.1 (K), D36.1 (K), D40.1 (K), D44.1 (K), D48.1 (K), D52.1 (K), D56.1 (K), D60.1 (K), D64.1 (K), D65.1 (K), D66.1 (K), J1.2 (G2), J2.3, P1.5, P4.21, P4.22, P4.23, P4.24, P4.25, P4.26, P4.27, P4.28, U1.8 (VSSA), U1.20 (PB2/BOOT1), U1.23 (VSS), U1.35 (VSS), U1.47 (VSS)
DI0: D4.2 (A), U1.18 (PB0/ADC1_IN8/ADC2_IN8/TIM1_CH2N/TIM3_CH3), U2.15
DI0v: C5.2, C6.2, C7.2, C8.2, C9.2, C10.2, C11.2, C12.2, C13.2, C14.2, C15.2, C16.2, C17.2, C18.2, C19.2, C20.2, D2.2 (A), D3.1 (K), D6.2 (A), D7.1 (K), D10.2 (A), D11.1 (K), D14.2 (A), D15.1 (K), D18.2 (A), D19.1 (K), D22.2 (A), D23.1 (K), D26.2 (A), D27.1 (K), D30.2 (A), D31.1 (K), D34.2 (A), D35.1 (K), D38.2 (A), D39.1 (K), D42.2 (A), D43.1 (K), D46.2 (A), D47.1 (K), D50.2 (A), D51.1 (K), D54.2 (A), D55.1 (K), D58.2 (A), D59.1 (K), D62.2 (A), D63.1 (K), P2.2, P3.2
DI1: D8.2 (A), U1.19 (PB1/ADC1_IN9/ADC2_IN9/TIM1_CH3N/TIM3_CH4), U2.13
DI2: D12.2 (A), U1.21 (PB10/I2C2_SCL/TIM2_CH3/USART3_TX), U2.11
DI3: D16.2 (A), U1.22 (PB11/ADC1_EXTI11/ADC2_EXTI11/I2C2_SDA/T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), U2.9
DI4: D20.2 (A), U1.25 (PB12/I2C2_SMBA/SPI2_NSS/TIM1_BKIN/USART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), U3.15
DI5: D24.2 (A), U1.26 (PB13/SPI2_SCK/TIM1_CH1N/USART3_CTS), U3.13
DI6: D28.2 (A), U1.27 (PB14/SPI2_MISO/TIM1_CH2N/USART3_RTS), U3.11
DI7: D32.2 (A), U1.28 (PB15/ADC1_EXTI15/ADC2_EXTI15/SPI2_MOSI/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), U3.9
DI8: D36.2 (A), U1.33 (CAN_TX/TIM1_ETR/USART1_RTS/USB_DP/PA12), U4.15
DI9: D40.2 (A), U1.38 (ADC1_EXTI15/ADC2_EXTI15/SPI1_NSS/SYS_JT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), U4.13
DI10: D44.2 (A), U1.39 (PB3/SPI1_SCK/SYS_JTDO-TRACESWO/TIM2_CH2), U4.11
DI11: D48.2 (A), U1.40 (PB4/SPI1_MISO/SYS_NJTRST/TIM3_CH1), U4.9
DI12: D52.2 (A), U1.41 (PB5/I2C1_SMBA/SPI1_MOSI/TIM3_CH2), U5.15
DI13: D56.2 (A), U1.42 (PB6/I2C1_SCL/TIM4_CH1/USART1_TX), U5.13
DI14: D60.2 (A), U1.43 (PB7/I2C1_SDA/TIM4_CH2/USART1_RX), U5.11
DI15: D64.2 (A), U1.45 (PB8/CAN_RX/I2C1_SCL/TIM4_CH3), U5.9
DI24v: P2.1, P3.1
IDI0: C5.1, D1.2 (A), D2.1 (K), P2.3
IDI1: C6.1, D5.2 (A), D6.1 (K), P2.4
IDI2: C7.1, D9.2 (A), D10.1 (K), P2.5
IDI3: C8.1, D13.2 (A), D14.1 (K), P2.6
IDI4: C9.1, D17.2 (A), D18.1 (K), P2.7
IDI5: C10.1, D21.2 (A), D22.1 (K), P2.8
IDI6: C11.1, D25.2 (A), D26.1 (K), P2.9
IDI7: C12.1, D29.2 (A), D30.1 (K), P2.10
IDI8: C13.1, D33.2 (A), D34.1 (K), P3.3
IDI9: C14.1, D37.2 (A), D38.1 (K), P3.4
IDI10: C15.1, D41.2 (A), D42.1 (K), P3.5
IDI11: C16.1, D45.2 (A), D46.1 (K), P3.6
IDI12: C17.1, D49.2 (A), D50.1 (K), P3.7
IDI13: C18.1, D53.2 (A), D54.1 (K), P3.8
IDI14: C19.1, D57.2 (A), D58.1 (K), P3.9
IDI15: C20.1, D61.2 (A), D62.1 (K), P3.10
unnamed: D1.1 (K), U2.1
unnamed: D3.2 (A), U2.2
unnamed: D5.1 (K), U2.3
unnamed: D7.2 (A), U2.4
unnamed: D9.1 (K), U2.5
unnamed: D11.2 (A), U2.6
unnamed: D13.1 (K), U2.7
unnamed: D15.2 (A), U2.8
unnamed: D17.1 (K), U3.1
unnamed: D19.2 (A), U3.2
unnamed: D21.1 (K), U3.3
unnamed: D23.2 (A), U3.4
unnamed: D25.1 (K), U3.5
unnamed: D27.2 (A), U3.6
unnamed: D29.1 (K), U3.7
unnamed: D31.2 (A), U3.8
unnamed: D33.1 (K), U4.1
unnamed: D35.2 (A), U4.2
unnamed: D37.1 (K), U4.3
unnamed: D39.2 (A), U4.4
unnamed: D41.1 (K), U4.5
unnamed: D43.2 (A), U4.6
unnamed: D45.1 (K), U4.7
unnamed: D47.2 (A), U4.8
unnamed: D49.1 (K), U5.1
unnamed: D51.2 (A), U5.2
unnamed: D53.1 (K), U5.3
unnamed: D55.2 (A), U5.4
unnamed: D57.1 (K), U5.5
unnamed: D59.2 (A), U5.6
unnamed: D61.1 (K), U5.7
unnamed: D63.2 (A), U5.8
unnamed: D65.2 (A), R18.2
unnamed: D66.2 (A), R19.2
unnamed: R2.1, U2.16
unnamed: R3.1, U2.14
unnamed: R4.1, U2.12
unnamed: R5.1, U2.10
unnamed: R6.1, U3.16
unnamed: R7.1, U3.14
unnamed: R8.1, U3.12
unnamed: R9.1, U3.10
unnamed: R10.1, U4.16
unnamed: R11.1, U4.14
unnamed: R12.1, U4.12
unnamed: R13.1, U4.10
unnamed: R14.1, U5.16
unnamed: R15.1, U5.14
unnamed: R16.1, U5.12
unnamed: R17.1, U5.10
RESET: P1.3, P4.1, P4.2, R1.2, U1.7 (NRST)
RX: J2.2, U1.31 (TIM1_CH3/USART1_RX/PA10)
SEL_IN: P4.10, U1.14 (ADC1_IN4/ADC2_IN4/SPI1_NSS/USART2_CK/PA4)
SEL_OUT: P4.9, U1.13 (ADC1_IN3/ADC2_IN3/TIM2_CH4/USART2_RX/PA3)
SFL: R19.1, U1.29 (RCC_MCO/TIM1_CH1/USART1_CK/PA8)
SOK: R18.1, U1.32 (ADC1_EXTI11/ADC2_EXTI11/CAN_RX/TIM1_CH4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)
SPI_MISO: P4.5, P4.6, U1.16 (ADC1_IN6/ADC2_IN6/SPI1_MISO/TIM1_BKIN/T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)
SPI_MOSI: P4.7, P4.8, U1.17 (ADC1_IN7/ADC2_IN7/SPI1_MOSI/TIM1_CH1N/T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)
SPI_SCK: P4.3, P4.4, U1.15 (ADC1_IN5/ADC2_IN5/SPI1_SCK/PA5)
SWCLK: P1.2, U1.37 (SYS_JTCK-SWCLK/PA14)
SWDIO: P1.1, U1.34 (SYS_JTMS-SWDIO/PA13)
TX: J2.1, U1.30 (TIM1_CH2/USART1_TX/PA9)
VDD: C1.1, C2.1, C3.1, P1.4, P4.11, P4.12, P4.13, P4.14, P4.15, P4.16, P4.17, P4.18, P4.19, P4.20, R1.1, R2.2, R3.2, R4.2, R5.2, R6.2, R7.2, R8.2, R9.2, R10.2, R11.2, R12.2, R13.2, R14.2, R15.2, R16.2, R17.2, R20.1, U1.1 (VBAT), U1.9 (VDDA), U1.24 (VDD), U1.36 (VDD), U1.48 (VDD)

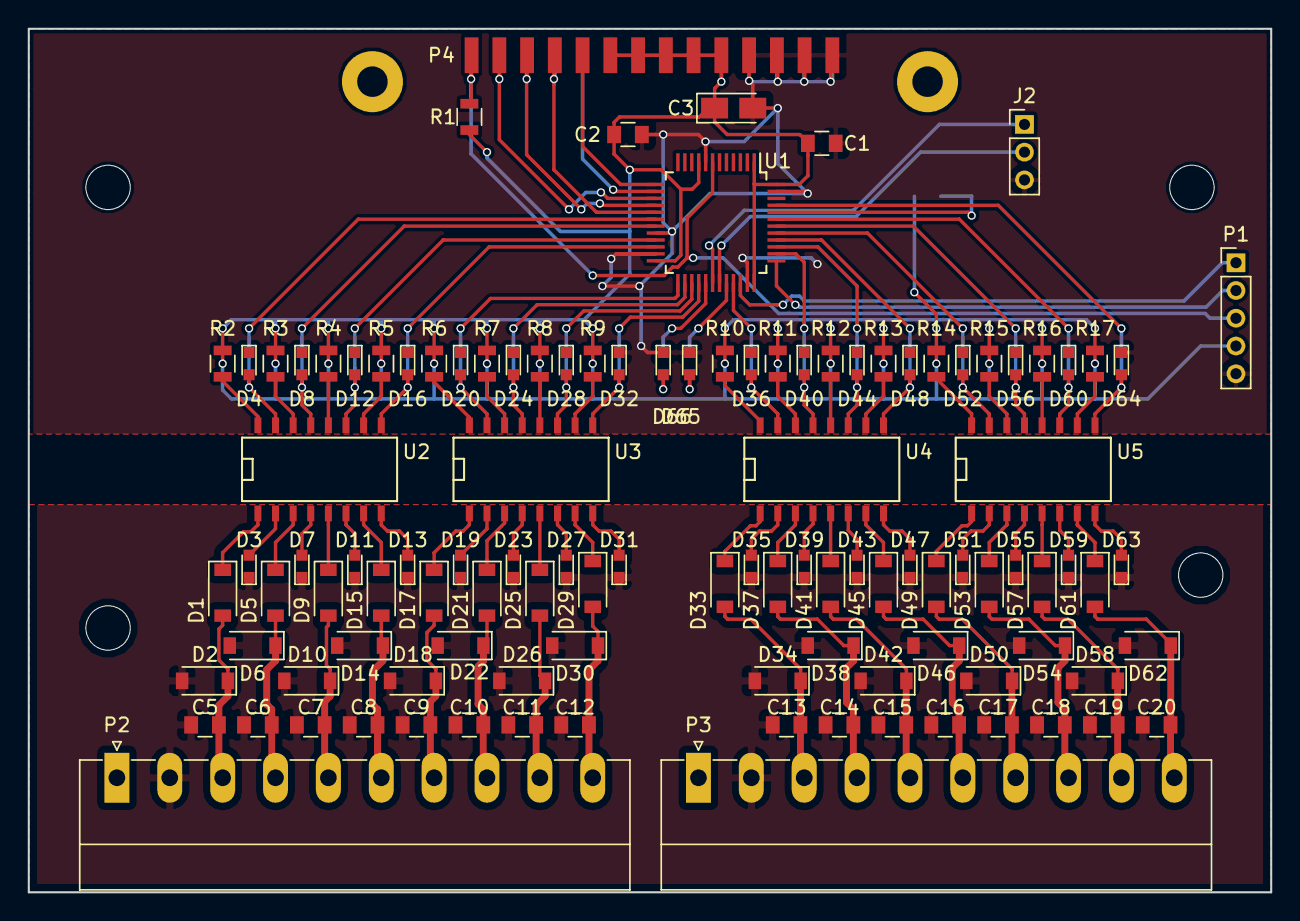
[picture p6: board module_di.kicad_pcb from above]

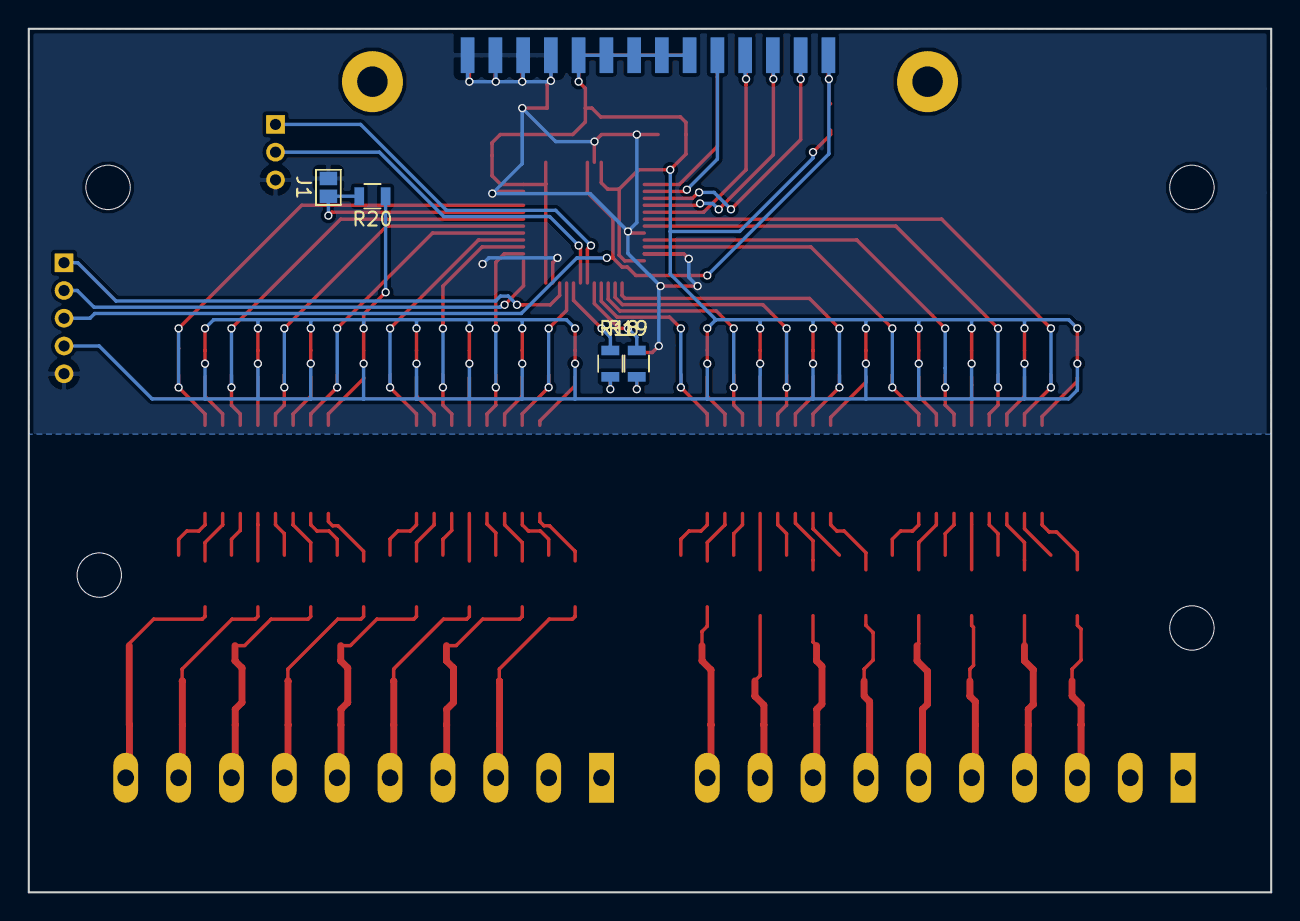
[picture p7: board module_di.kicad_pcb from below]

Board: 2 copper layers, 89.5 x 62.2 mm, 116 parts (4 on the bottom side), 99 nets.
