andreili/STM32-PLC/firmware/fw_di16/inc/main.h

#define DI0_Pin GPIO_PIN_13
#define DI0_GPIO_Port GPIOC
#define DI1_Pin GPIO_PIN_14
#define DI1_GPIO_Port GPIOC
#define DI2_Pin GPIO_PIN_15
#define DI2_GPIO_Port GPIOC
#define SEL_IN_Pin GPIO_PIN_0
#define SEL_IN_GPIO_Port GPIOD
#define SEL_OUT_Pin GPIO_PIN_1
#define SEL_OUT_GPIO_Port GPIOD
#define DI3_Pin GPIO_PIN_0
#define DI3_GPIO_Port GPIOA
#define DI4_Pin GPIO_PIN_1
#define DI4_GPIO_Port GPIOA
#define DI5_Pin GPIO_PIN_2
#define DI5_GPIO_Port GPIOA
#define DI6_Pin GPIO_PIN_3
#define DI6_GPIO_Port GPIOA
#define DI7_Pin GPIO_PIN_4
#define DI7_GPIO_Port GPIOA
#define DI8_Pin GPIO_PIN_12
#define DI8_GPIO_Port GPIOB
#define DI9_Pin GPIO_PIN_13
#define DI9_GPIO_Port GPIOB
#define DI10_Pin GPIO_PIN_14
#define DI10_GPIO_Port GPIOB
#define DI11_Pin GPIO_PIN_15
#define DI11_GPIO_Port GPIOB
#define DI12_Pin GPIO_PIN_8
#define DI12_GPIO_Port GPIOA
#define DI13_Pin GPIO_PIN_9
#define DI13_GPIO_Port GPIOA
#define DI14_Pin GPIO_PIN_10
#define DI14_GPIO_Port GPIOA
#define DI15_Pin GPIO_PIN_11
#define DI15_GPIO_Port GPIOA
