andreili/STM32-PLC/stlc/stlc.cpp

#include "stlc.h"
#include "plc_hw.h"
#include "Stream.h"
#include <regex>
#include <sstream>

#define STL_WHITESPACES " \t\n\r;"
#define STL_DB_HEADER "DATA_BLOCK"
#define STL_OB_HEADER "ORGANIZATION_BLOCK"
#define STL_OB_ABBR "OB"
#define STL_OB_END_MARKER "END_ORGANIZATION_BLOCK"
#define STL_FB_HEADER "FUNCTION_BLOCK"
#define STL_FB_ABBR "FB"
#define STL_FB_END_MARKER "END_FUNCTION_BLOCK"
#define STL_FC_HEADER "FUNCTION"
#define STL_FC_ABBR "FC"
#define STL_FC_END_MARKER "END_FUNCTION"

STLC* STLC::m_instance;
EParseSubLocation stl_next_sub = EParseSubLocation::NONE;

bool isFloat(std::string str)
{
    std::istringstream iss(str);
    float f;
    iss >> std::noskipws >> f; // noskipws considers leading whitespace invalid
    // Check the entire string was consumed and if either failbit or badbit is set
    return iss.eof() && !iss.fail();
}

bool is_number(const std::string& s)
{
    return !s.empty() && std::find_if(s.begin(),
        s.end(), [](char c) { return !std::isdigit(c); }) == s.end();
}

STLC::STLC()
{
    m_instance = this;
}

bool STLC::load_plain(std::string file_name, bool iec)
{
    printf("Loading sources from '%s'.\n", file_name.c_str());
    Stream stream(file_name, FILE_OPEN_READ_ST);
    if (!stream.opened())
        return false;
    if (iec)
    {
        printf("Unsupported mode - IEC ST!\n");
        return false;
    }
    else if (!parse_stl_plain(&stream))
        return false;
    printf("Loaded %i lines.\n", m_plain.size());
    return true;
}

bool STLC::compile(std::string file_name)
{
    (void)(file_name);
    return true;
}

bool STLC::parse_stl_plain(Stream* stream)
{
    m_plain.clear();
    EParseMainLocation location = EParseMainLocation::NONE;

    // read all texts from source file
    std::string in_buf;
    in_buf.resize(stream->getSize());
    stream->read(&in_buf[0], stream->getSize());

    std::regex reg_comm("(\\/\\/.*)", std::regex_constants::icase);
    std::regex reg_sp("([[:blank:]]{2,})", std::regex_constants::icase);

    size_t start_pos = 0;
    size_t end_pos = in_buf.size();
    int line_idx = 1;
    stl_plaint_line_t plain;
    plain.inst_block = EBlockType::NONE;
    plain.inst_no = -1;
    while (start_pos < end_pos)
    {
        size_t sub_end = in_buf.find_first_of("\r\n", start_pos);
        std::string line_raw, line;
        if ((in_buf.length() > sub_end) && (in_buf[sub_end + 1] == '\n'))
            ++sub_end;
        line_raw = line = in_buf.substr(start_pos, sub_end - start_pos);

        plain.line_raw = line;
        plain.comment = "";
        plain.label = "";
        plain.title = "";
        if (stl_next_sub != EParseSubLocation::NONE)
            plain.loc_sub = stl_next_sub;

        line = std::regex_replace(line, reg_comm, "");
        line = std::regex_replace(line, reg_sp, " ");
        const auto strBegin = line.find_first_not_of(STL_WHITESPACES);
        // skip whitespaced lines
        if ((line.length() == 0) || (strBegin == std::string::npos))
        {
            start_pos = sub_end + 1;
            ++line_idx;
            continue;
        }

        const auto strEnd = line.find_last_not_of(STL_WHITESPACES);
        const auto strRange = strEnd - strBegin + 1;
        line = line.substr(strBegin, strRange);

        line = std::regex_replace(line, std::regex("([[:blank:]]*:=[[:blank:]]*)", std::regex_constants::icase), ":=");
        line = std::regex_replace(line, std::regex("([[:graph:]]+)[[:blank:]]*=[[:blank:]]*", std::regex_constants::icase), "$1=");
        line = std::regex_replace(line, std::regex("([[:blank:]]*:[[:blank:]]*)", std::regex_constants::icase), ":");
        std::transform(line.begin(), line.end(), line.begin(), ::toupper);
        if (line.length() == 0)
        {
            start_pos = sub_end + 1;
            ++line_idx;
            continue;
        }

        if (location == EParseMainLocation::NONE)
        {
            location = parse_stl_plain_location(line);
            if (location == EParseMainLocation::NONE)
            {
                printf("Unknown loation at line %i:\n%s\n", line_idx, line_raw.c_str());
                return false;
            }
            printf("Parse %s\n", line.c_str());
            // set location for a plain line
            plain.loc = location;
            plain.loc_sub = EParseSubLocation::HEADER;
        }

        EParseResult res = EParseResult::OK;
        switch (location)
        {
        case EParseMainLocation::NONE:
            // nothing
            break;
        case EParseMainLocation::DATA_BLOCK:
            res = parse_stl_plain_DB(line, plain);
            break;
        case EParseMainLocation::ORGANIZATION_BLOCK:
            res = parse_stl_plain_code_block(line, plain, STL_OB_HEADER, STL_OB_ABBR, STL_OB_END_MARKER);
            break;
        case EParseMainLocation::FUNCTION:
            res = parse_stl_plain_code_block(line, plain, STL_FC_HEADER, STL_FC_ABBR, STL_FC_END_MARKER);
            break;
        case EParseMainLocation::FUNCTION_BLOCK:
            res = parse_stl_plain_code_block(line, plain, STL_FB_HEADER, STL_FB_ABBR, STL_FB_END_MARKER);
            break;
        }

        switch (res)
        {
        case EParseResult::OK:
            // nothing
            break;
        case EParseResult::PERROR:
            printf("At line %i:\n%s\n", line_idx, line_raw.c_str());
            return false;
        case EParseResult::WARNING:
            printf("At line %i:\n%s\n", line_idx, line_raw.c_str());
            break;
        case EParseResult::SKIP:
        case EParseResult::NOT_APP:
            start_pos = sub_end + 1;
            ++line_idx;
            continue;
        case EParseResult::BLOCK_END:
            start_pos = sub_end + 1;
            ++line_idx;
            location = EParseMainLocation::NONE;
            plain.loc_sub = EParseSubLocation::NONE;
            continue;
        }

        stl_plaint_line_t *pl_new = new stl_plaint_line_t;
        *pl_new = plain;
        m_plain.push_back(pl_new);

        start_pos = sub_end + 1;
        ++line_idx;
    }

    return true;
}

EParseMainLocation STLC::parse_stl_plain_location(std::string &line)
{
    size_t ws_pos = line.find_first_of(STL_WHITESPACES);
    if (ws_pos != std::string::npos)
    {
        std::string loc_str = line.substr(0, ws_pos);
        if (loc_str.compare(STL_DB_HEADER) == 0)
            return EParseMainLocation::DATA_BLOCK;
        else if (loc_str.compare("ORGANIZATION_BLOCK") == 0)
            return EParseMainLocation::ORGANIZATION_BLOCK;
        else if (loc_str.compare("FUNCTION") == 0)
            return EParseMainLocation::FUNCTION;
        else if (loc_str.compare("FUNCTION_BLOCK") == 0)
            return EParseMainLocation::FUNCTION_BLOCK;
    }
    return EParseMainLocation::NONE;
}

/*
 * Typical Data Block:
 *  DATA_BLOCK DB 1
 *  TITLE = Example block title
 *  VERSION : 0.1 // optional
 *
 *  STRUCT
 *   var1 : INT;
 *   var1 : BOOL;
 *   var3 : REAL;
 *  END_STRUCT
 *  BEGIN
 *   var1 := 1024;
 *   var2 := true;
 *   var3 := 0.01;
 *  END_DATA_BLOCK
 * */

EParseResult STLC::parse_stl_plain_DB(std::string &line, stl_plaint_line_t &plain)
{
    while (1)
    {
        EParseResult res = EParseResult::SKIP;
        switch (plain.loc_sub)
        {
        case EParseSubLocation::HEADER:
            res = parse_stl_plain_block_header(line, plain, STL_DB_HEADER, "DB");
            break;
        case EParseSubLocation::STRUCTURE:
            res = parse_stl_plain_var_struct(line, plain, "END_STRUCT", EParameterLocation::DB);
            break;
        case EParseSubLocation::DATA_INIT:
            res = parse_stl_plain_DB_data_init(line, plain);
            break;
        case EParseSubLocation::NONE:
            break;
        case EParseSubLocation::VAR_INPUT:
        case EParseSubLocation::VAR_OUTPUT:
        case EParseSubLocation::VAR_INOUT:
        case EParseSubLocation::VAR_TEMP:
        case EParseSubLocation::VAR_STATIC:
        case EParseSubLocation::NETWORK:
        case EParseSubLocation::CALL_PARAMETERS:
            printf("Error: Invalid location on Data Block!\n");
            return EParseResult::PERROR;
        }

        if (res != EParseResult::SKIP)
            return res;

        if (parse_stl_plain_DB_check_sub(line, plain))
            break;
        else
            return EParseResult::PERROR;
    }
    return EParseResult::NOT_APP;
}

EParseResult STLC::parse_stl_plain_code_block(std::string &line, stl_plaint_line_t &plain,
                                              const char* block_header, const char* block_abbr,
                                              const char* end_marker)
{
    while (1)
    {
        EParseResult res = EParseResult::SKIP;
        switch (plain.loc_sub)
        {
        case EParseSubLocation::HEADER:
            res = parse_stl_plain_block_header(line, plain, block_header, block_abbr);
            plain.nw_idx = 0;
            break;
        case EParseSubLocation::STRUCTURE:
        case EParseSubLocation::DATA_INIT:
            printf("Error: Invalid location on Organization Block!\n");
            return EParseResult::PERROR;
        case EParseSubLocation::NONE:
            break;
        case EParseSubLocation::VAR_INPUT:
            res = parse_stl_plain_var_struct(line, plain, "END_VAR", EParameterLocation::BLOCK_INPUT);
            break;
        case EParseSubLocation::VAR_OUTPUT:
            res = parse_stl_plain_var_struct(line, plain, "END_VAR", EParameterLocation::BLOCK_OUTPUT);
            break;
        case EParseSubLocation::VAR_INOUT:
            res = parse_stl_plain_var_struct(line, plain, "END_VAR", EParameterLocation::BLOCK_INOUT);
            break;
        case EParseSubLocation::VAR_TEMP:
            res = parse_stl_plain_var_struct(line, plain, "END_VAR", EParameterLocation::BLOCK_TEMP);
            break;
        case EParseSubLocation::VAR_STATIC:
            res = parse_stl_plain_var_struct(line, plain, "END_VAR", EParameterLocation::BLOCK_STATIC);
            break;
        case EParseSubLocation::NETWORK:
            res = parse_stl_plain_network(line, plain, end_marker);
            break;
        case EParseSubLocation::CALL_PARAMETERS:
            res = parse_stl_plain_call_parameter(line, plain);
            break;
        }

        if (res != EParseResult::SKIP)
            return res;

        if (parse_stl_plain_OB_check_sub(line, plain))
            break;
    }
    return EParseResult::NOT_APP;
}

EDataType STLC::parse_data_type(std::string str)
{
    if (str.compare("BOOL") == 0)
        return EDataType::BOOL;
    else if (str.compare("BYTE") == 0)
        return EDataType::BYTE;
    else if (str.compare("CHAR") == 0)
        return EDataType::CHAR;
    else if (str.compare("WORD") == 0)
        return EDataType::WORD;
    else if (str.compare("DWORD") == 0)
        return EDataType::DWORD;
    else if (str.compare("INT") == 0)
        return EDataType::INT;
    else if (str.compare("DINT") == 0)
        return EDataType::DINT;
    else if (str.compare("REAL") == 0)
        return EDataType::REAL;
    else if (str.compare("S5TIME") == 0)
        return EDataType::S5TIME;
    else if (str.compare("TIME") == 0)
        return EDataType::TIME;
    else if (str.compare("DATE") == 0)
        return EDataType::DATE;
    else if (str.compare("TIME_OF_DAY") == 0)
        return EDataType::TIME_OF_DAY;
    else if (str.compare("DATE_AND_TIME") == 0)
        return EDataType::DATE_AND_TIME;
    else if (str.compare("STRING") == 0)
        return EDataType::STRING;
    else if (str.compare("ARRAY") == 0)
        return EDataType::ARRAY;
    else if (str.compare("ADDR") == 0)
        return EDataType::ADDR;
    else if (str.compare("VOID") == 0)
        return EDataType::_VOID;
    else
    {
        printf("Error: Unknown data type:\n%s\n", str.c_str());
        return EDataType::NONE;
    }
}

EParseResult STLC::parse_value(std::string str, EDataType type, plc_data_t &value)
{
    switch (type)
    {
    case EDataType::NONE:
        break;
    case EDataType::BOOL:
        if (str.compare("TRUE") == 0)
            value.bool_val = true;
        else if (str.compare("FALSE") == 0)
            value.bool_val = false;
        break;
    case EDataType::BYTE:
        value.BYTE = std::stoi(str);
        break;
    case EDataType::CHAR:
        value.CHAR = str[0];    //TODO
        break;
    case EDataType::WORD:
        value.WORD = std::stoi(str);
        break;
    case EDataType::DWORD:
        value.DWORD = std::stoi(str);
        break;
    case EDataType::INT:
        value.INT = std::stoi(str);
        break;
    case EDataType::DINT:
        value.DINT = std::stoi(str);
        break;
    case EDataType::REAL:
        value.REAL = std::stof(str);
        break;
    case EDataType::S5TIME:
    case EDataType::TIME:
    case EDataType::DATE:
    case EDataType::TIME_OF_DAY:
    case EDataType::DATE_AND_TIME:
    case EDataType::STRING:
    case EDataType::ARRAY:
    case EDataType::ADDR:
    case EDataType::_VOID:
        printf("Error: Unsupported value type!\n");
        return EParseResult::PERROR;
    }
    return EParseResult::OK;
}

stl_plaint_line_t* STLC::find_var_def(std::string name, int block_no, EParseMainLocation loc)
{
    for (stl_plaint_line_t *pl : m_instance->m_plain)
    {
        if (pl->loc != loc)
            continue;
        if (pl->block_no != block_no)
            continue;
        /*if (pl->loc_sub != EParseSubLocation::STRUCTURE)
            continue;*/
        if (pl->var_name.compare(name) == 0)
            return pl;
    }
    return nullptr;
}

std::string STLC::parse_title(std::string &str)
{
    size_t pos = str.find_first_not_of('=', 5);
    pos = str.find_first_not_of(STL_WHITESPACES, pos);
    if (pos != std::string::npos)
    {
        std::string title = str.substr(pos);
        if (title[0] == '"')
        {
            title.erase(0, 1);
            title.erase(title.length() - 1, 1);
        }
        return title;
    }
    else
        return "";
}

EParseResult STLC::parse_stl_plain_block_header(std::string &line, stl_plaint_line_t &plain, const char* header, const char* block_abbr)
{
    plain.header_type = EParseHeaderType::NONE;
    if (line.compare(0, strlen(header), header) == 0)
    {
        std::string db_str = line.substr(strlen(header) + 1, 2);
        if (db_str.compare(block_abbr))
        {
            printf("Error: Invalid block header!\n");
            return EParseResult::PERROR;
        }
        db_str = line.substr(strlen(header) + 4);

        if (plain.loc == EParseMainLocation::FUNCTION)
        {
            // parse result type
            size_t pos = db_str.find_first_of(':');
            plain.result_type = parse_data_type(db_str.substr(pos + 1));
            db_str = db_str.substr(0, pos);
        }

        plain.block_no = std::stoi(db_str);
        return EParseResult::NOT_APP;
    }
    else if (line.compare(0, 5, "TITLE") == 0)
    {
        plain.header_type = EParseHeaderType::TITLE;
        plain.title = parse_title(line);
        return EParseResult::OK;
    }
    else if (line.compare(0, 7, "VERSION") == 0)
    {
        // not applicable
        return EParseResult::NOT_APP;
    }
    else
        return EParseResult::SKIP;
}

EParseResult STLC::parse_stl_plain_var_struct(std::string &line, stl_plaint_line_t &plain,
                                              const char* end_label, EParameterLocation par_loc)
{
    if (line.compare(end_label) == 0)
    {
        plain.loc_sub = EParseSubLocation::NONE;
        return EParseResult::NOT_APP;
    }

    plain.par_loc = par_loc;
    plain.var_name = line.substr(0, line.find_first_of(':'));
    plain.var_type = STLC::parse_data_type(line.substr(plain.var_name.length() + 1));
    if (plain.var_type == EDataType::NONE)
        return EParseResult::PERROR;
    else
        return EParseResult::OK;
}

EParseResult STLC::parse_stl_plain_DB_data_init(std::string &line, stl_plaint_line_t &plain)
{
    if (line.compare("END_DATA_BLOCK") == 0)
    {
        plain.inst_block = EBlockType::NONE;
        plain.inst_no = -1;
        return EParseResult::BLOCK_END;
    }

    plain.var_name = line.substr(0, line.find_first_of(':'));
    stl_plaint_line_t *var_def = STLC::find_var_def(plain.var_name, plain.block_no, plain.loc);
    if (var_def == nullptr)
    {
        if (plain.inst_block != EBlockType::NONE)
        {
            printf("Warning: early assignment of value\n");
            plain.label = line.substr(plain.var_name.length() + 2);
            return EParseResult::WARNING;
        }
        else
        {
            printf("Error: Unknown variable name!\n");
            return EParseResult::PERROR;
        }
    }
    if (STLC::parse_value(line.substr(plain.var_name.length() + 2), var_def->var_type,
                          var_def->var_value) != EParseResult::OK)
        return EParseResult::PERROR;
    return EParseResult::NOT_APP;
}

bool STLC::parse_stl_plain_DB_check_sub(std::string &line, stl_plaint_line_t &plain)
{
    if (line.compare("STRUCT") == 0)
    {
        plain.loc_sub = EParseSubLocation::STRUCTURE;
        return true;
    }
    else if (line.compare("BEGIN") == 0)
    {
        plain.loc_sub = EParseSubLocation::DATA_INIT;
        return true;
    }
    else if ((line.compare(0, 2, "FB") == 0) || (line.compare(0, 3, "SFB") == 0))
    {
        // Instance DB
        size_t pos = line.find_first_of(STL_WHITESPACES);
        if (pos == std::string::npos)
        {
            printf("Error: invalid instance data block declaration!\n");
            return false;
        }
        if (line.compare(0, 3, "SFB") == 0)
            plain.inst_block = EBlockType::SFB;
        else
            plain.inst_block = EBlockType::FB;
        std::string str = line.substr(pos + 1);
        if (!is_number(str))
        {
            printf("Error: invalid instance data block declaration!\n");
            return false;
        }
        plain.inst_no = std::stoi(str);
        return true;
    }
    else
    {
        printf("Error: Unknown Data Block substitute!\n");
        return false;
    }
}

bool STLC::parse_stl_plain_OB_check_sub(std::string &line, stl_plaint_line_t &plain)
{
    if (line.compare("VAR_INPUT") == 0)
    {
        plain.loc_sub = EParseSubLocation::VAR_INPUT;
        return true;
    }
    else if (line.compare("VAR_OUTPUT") == 0)
    {
        plain.loc_sub = EParseSubLocation::VAR_OUTPUT;
        return true;
    }
    else if (line.compare("VAR_INOUT") == 0)
    {
        plain.loc_sub = EParseSubLocation::VAR_INOUT;
        return true;
    }
    else if (line.compare("VAR_TEMP") == 0)
    {
        plain.loc_sub = EParseSubLocation::VAR_TEMP;
        return true;
    }
    else if (line.compare("VAR_STATIC") == 0)
    {
        plain.loc_sub = EParseSubLocation::VAR_STATIC;
        return true;
    }
    else if (line.compare("NETWORK") == 0)
    {
        plain.loc_sub = EParseSubLocation::NETWORK;
        ++plain.nw_idx;
        return true;
    }
    else if (line.compare("BEGIN") == 0)
        return true;
    else
    {
        printf("Error: Unknown Organization Block substitute!\n");
        return false;
    }
}

EParseResult STLC::parse_stl_plain_network(std::string &line, stl_plaint_line_t &plain, const char* end_block_label)
{
    if (line.compare(end_block_label) == 0)
        return EParseResult::BLOCK_END;

    if (line.compare(0, 5, "TITLE") == 0)
    {
        plain.header_type = EParseHeaderType::TITLE;
        plain.title = parse_title(line);
        if (plain.title.length())
            printf("\tNetwork #%i: %s\n", plain.nw_idx, plain.title.c_str());
        else
            printf("\tNetwork #%i\n", plain.nw_idx);
        return EParseResult::OK;
    }

    size_t pos = line.find_first_of(STL_WHITESPACES);
    size_t pos_label = line.find_first_of(':');
    if (pos_label < pos)
    {
        plain.label = line.substr(0, pos_label - 1);
        line.erase(0, pos_label + 1);
        pos = line.find_first_of(STL_WHITESPACES);
    }
    std::string mnemonic = line.substr(0, pos);

    if (mnemonic.compare("NETWORK") == 0)
        return EParseResult::SKIP;

    stl_next_sub = EParseSubLocation::NONE;
    for (int i=0 ; i<STL_CMD_COUNT ; ++i)
        if (mnemonic.compare(STL_CMDs[i].mnemonic) == 0)
        {
            plain.cmd = &STL_CMDs[i];
            if (plain.cmd->command == ESTLCommand::CALL)
                stl_next_sub = EParseSubLocation::CALL_PARAMETERS;
            if (pos != std::string::npos)
                return parse_stl_parameter_location(line.substr(pos + 1), plain);
            else
                return EParseResult::OK;
        }

    printf("Error: Unknown mnemonic!\n");
    return EParseResult::PERROR;
}

EParseResult STLC::parse_stl_plain_call_parameter(std::string &line, stl_plaint_line_t &plain)
{
    if (line[line.length() - 1] == ')')
    {
        stl_next_sub = EParseSubLocation::NETWORK;
        line.erase(line.length() - 1, 1);
    }

    size_t pos = line.find_first_of(':');
    if ((pos == std::string::npos) || (line[pos + 1] != '='))
    {
        printf("Error: invalid call parameters, expected ':='\n");
        return EParseResult::PERROR;
    }

    plain.par_name = line.substr(0, pos);
    std::string loc = line.substr(pos + 1);
    return parse_stl_parameter_location(loc, plain);
}

EParseResult STLC::parse_stl_parameter_location(std::string str, stl_plaint_line_t &plain)
{
    size_t pos = str.find_first_of(STL_WHITESPACES);
    if (pos == std::string::npos)
    {
        // constant
        if (isFloat(str))
        {
            plain.par_loc = EParameterLocation::CONSTANT;
            if (is_number(str))
                plain.par_addr.DINT = std::stoi(str);
            else
                plain.par_addr.REAL = std::stof(str);
            return EParseResult::OK;
        }

        if (str[0] != '#')
        {
            // check registers
            if (parse_stl_parameter_SW(str, plain))
                return EParseResult::OK;

            // check jump label
            if (plain.cmd->category == ESTLCategory::Jumps)
            {
                plain.label = str;
                return EParseResult::OK;
            }

            printf("Error: invalid variable declaration!\n");
            return EParseResult::PERROR;
        }

        str = str.erase(0, 1);
        stl_plaint_line_t *pl = find_var_def(str, plain.block_no, plain.loc);
        if (pl == nullptr)
        {
            printf("Error: Unknown variable!\n");
            return EParseResult::PERROR;
        }
        // variable
        plain.par_loc = pl->par_loc;
        plain.var_name = pl->var_name;
    }

    return EParseResult::OK;
}

bool STLC::parse_stl_parameter_SW(std::string str, stl_plaint_line_t &plain)
{
    if (str.compare("RLO") == 0)
        plain.par_addr.ADDR = PLC_STATUS_RLO_MASK;
    else if (str.compare("STA") == 0)
        plain.par_addr.ADDR = PLC_STATUS_STA_MASK;
    else if (str.compare("OR") == 0)
        plain.par_addr.ADDR = PLC_STATUS_OR_MASK;
    else if (str.compare("OS") == 0)
        plain.par_addr.ADDR = PLC_STATUS_OS_MASK;
    else if (str.compare("OV") == 0)
        plain.par_addr.ADDR = PLC_STATUS_OV_MASK;
    else if (str.compare("CC0") == 0)
        plain.par_addr.ADDR = PLC_STATUS_CC0_MASK;
    else if (str.compare("CC1") == 0)
        plain.par_addr.ADDR = PLC_STATUS_CC1_MASK;
    else if (str.compare("BR") == 0)
        plain.par_addr.ADDR = PLC_STATUS_BR_MASK;
    else
        return false;
    return true;
}
