andreili/STM32-PLC/firmware/fw_cpu/platforms/stm32/stm32_gpio.h

#ifndef __STM32_GPIO__
#define __STM32_GPIO__

#include <stdint.h>
#include "stm32f4xx.h"

#define GPIO_PIN_0                 ((uint16_t)0x0001U)  /* Pin 0 selected    */
#define GPIO_PIN_1                 ((uint16_t)0x0002U)  /* Pin 1 selected    */
#define GPIO_PIN_2                 ((uint16_t)0x0004U)  /* Pin 2 selected    */
#define GPIO_PIN_3                 ((uint16_t)0x0008U)  /* Pin 3 selected    */
#define GPIO_PIN_4                 ((uint16_t)0x0010U)  /* Pin 4 selected    */
#define GPIO_PIN_5                 ((uint16_t)0x0020U)  /* Pin 5 selected    */
#define GPIO_PIN_6                 ((uint16_t)0x0040U)  /* Pin 6 selected    */
#define GPIO_PIN_7                 ((uint16_t)0x0080U)  /* Pin 7 selected    */
#define GPIO_PIN_8                 ((uint16_t)0x0100U)  /* Pin 8 selected    */
#define GPIO_PIN_9                 ((uint16_t)0x0200U)  /* Pin 9 selected    */
#define GPIO_PIN_10                ((uint16_t)0x0400U)  /* Pin 10 selected   */
#define GPIO_PIN_11                ((uint16_t)0x0800U)  /* Pin 11 selected   */
#define GPIO_PIN_12                ((uint16_t)0x1000U)  /* Pin 12 selected   */
#define GPIO_PIN_13                ((uint16_t)0x2000U)  /* Pin 13 selected   */
#define GPIO_PIN_14                ((uint16_t)0x4000U)  /* Pin 14 selected   */
#define GPIO_PIN_15                ((uint16_t)0x8000U)  /* Pin 15 selected   */
#define GPIO_PIN_All               ((uint16_t)0xFFFFU)  /* All pins selected */

/** @defgroup GPIO_mode_define GPIO mode define
  * @brief GPIO Configuration Mode 
  *        Elements values convention: 0xX0yz00YZ
  *           - X  : GPIO mode or EXTI Mode
  *           - y  : External IT or Event trigger detection 
  *           - z  : IO configuration on External IT or Event
  *           - Y  : Output type (Push Pull or Open Drain)
  *           - Z  : IO Direction mode (Input, Output, Alternate or Analog)
  * @{
  */ 
#define  GPIO_MODE_INPUT                        ((uint32_t)0x00000000U)   /*!< Input Floating Mode                   */
#define  GPIO_MODE_OUTPUT_PP                    ((uint32_t)0x00000001U)   /*!< Output Push Pull Mode                 */
#define  GPIO_MODE_OUTPUT_OD                    ((uint32_t)0x00000011U)   /*!< Output Open Drain Mode                */
#define  GPIO_MODE_AF_PP                        ((uint32_t)0x00000002U)   /*!< Alternate Function Push Pull Mode     */
#define  GPIO_MODE_AF_OD                        ((uint32_t)0x00000012U)   /*!< Alternate Function Open Drain Mode    */

#define  GPIO_MODE_ANALOG                       ((uint32_t)0x00000003U)   /*!< Analog Mode  */
    
#define  GPIO_MODE_IT_RISING                    ((uint32_t)0x10110000U)   /*!< External Interrupt Mode with Rising edge trigger detection          */
#define  GPIO_MODE_IT_FALLING                   ((uint32_t)0x10210000U)   /*!< External Interrupt Mode with Falling edge trigger detection         */
#define  GPIO_MODE_IT_RISING_FALLING            ((uint32_t)0x10310000U)   /*!< External Interrupt Mode with Rising/Falling edge trigger detection  */
 
#define  GPIO_MODE_EVT_RISING                   ((uint32_t)0x10120000U)   /*!< External Event Mode with Rising edge trigger detection               */
#define  GPIO_MODE_EVT_FALLING                  ((uint32_t)0x10220000U)   /*!< External Event Mode with Falling edge trigger detection              */
#define  GPIO_MODE_EVT_RISING_FALLING           ((uint32_t)0x10320000U)   /*!< External Event Mode with Rising/Falling edge trigger detection       */
/**
  * @}
  */

/** @defgroup GPIO_speed_define  GPIO speed define
  * @brief GPIO Output Maximum frequency
  * @{
  */
#define  GPIO_SPEED_FREQ_LOW         ((uint32_t)0x00000000U)  /*!< IO works at 2 MHz, please refer to the product datasheet */
#define  GPIO_SPEED_FREQ_MEDIUM      ((uint32_t)0x00000001U)  /*!< range 12,5 MHz to 50 MHz, please refer to the product datasheet */
#define  GPIO_SPEED_FREQ_HIGH        ((uint32_t)0x00000002U)  /*!< range 25 MHz to 100 MHz, please refer to the product datasheet  */
#define  GPIO_SPEED_FREQ_VERY_HIGH   ((uint32_t)0x00000003U)  /*!< range 50 MHz to 200 MHz, please refer to the product datasheet  */
/**
  * @}
  */

 /** @defgroup GPIO_pull_define GPIO pull define
   * @brief GPIO Pull-Up or Pull-Down Activation
   * @{
   */  
#define  GPIO_NOPULL        ((uint32_t)0x00000000U)   /*!< No Pull-up or Pull-down activation  */
#define  GPIO_PULLUP        ((uint32_t)0x00000001U)   /*!< Pull-up activation                  */
#define  GPIO_PULLDOWN      ((uint32_t)0x00000002U)   /*!< Pull-down activation                */


/** @defgroup GPIO_Alternate_function_selection GPIO Alternate Function Selection
  * @{
  */

/** 
  * @brief   AF 0 selection  
  */ 
#define GPIO_AF0_RTC_50Hz      ((uint8_t)0x00U)  /* RTC_50Hz Alternate Function mapping                       */
#define GPIO_AF0_MCO           ((uint8_t)0x00U)  /* MCO (MCO1 and MCO2) Alternate Function mapping            */
#define GPIO_AF0_TAMPER        ((uint8_t)0x00U)  /* TAMPER (TAMPER_1 and TAMPER_2) Alternate Function mapping */
#define GPIO_AF0_SWJ           ((uint8_t)0x00U)  /* SWJ (SWD and JTAG) Alternate Function mapping             */
#define GPIO_AF0_TRACE         ((uint8_t)0x00U)  /* TRACE Alternate Function mapping                          */

/** 
  * @brief   AF 1 selection  
  */ 
#define GPIO_AF1_TIM1          ((uint8_t)0x01U)  /* TIM1 Alternate Function mapping */
#define GPIO_AF1_TIM2          ((uint8_t)0x01U)  /* TIM2 Alternate Function mapping */

/** 
  * @brief   AF 2 selection  
  */ 
#define GPIO_AF2_TIM3          ((uint8_t)0x02U)  /* TIM3 Alternate Function mapping */
#define GPIO_AF2_TIM4          ((uint8_t)0x02U)  /* TIM4 Alternate Function mapping */
#define GPIO_AF2_TIM5          ((uint8_t)0x02U)  /* TIM5 Alternate Function mapping */

/** 
  * @brief   AF 3 selection  
  */ 
#define GPIO_AF3_TIM8          ((uint8_t)0x03U)  /* TIM8 Alternate Function mapping  */
#define GPIO_AF3_TIM9          ((uint8_t)0x03U)  /* TIM9 Alternate Function mapping  */
#define GPIO_AF3_TIM10         ((uint8_t)0x03U)  /* TIM10 Alternate Function mapping */
#define GPIO_AF3_TIM11         ((uint8_t)0x03U)  /* TIM11 Alternate Function mapping */

/** 
  * @brief   AF 4 selection  
  */ 
#define GPIO_AF4_I2C1          ((uint8_t)0x04U)  /* I2C1 Alternate Function mapping */
#define GPIO_AF4_I2C2          ((uint8_t)0x04U)  /* I2C2 Alternate Function mapping */
#define GPIO_AF4_I2C3          ((uint8_t)0x04U)  /* I2C3 Alternate Function mapping */

/** 
  * @brief   AF 5 selection  
  */ 
#define GPIO_AF5_SPI1          ((uint8_t)0x05U)  /* SPI1 Alternate Function mapping        */
#define GPIO_AF5_SPI2          ((uint8_t)0x05U)  /* SPI2/I2S2 Alternate Function mapping   */
#define GPIO_AF5_SPI3          ((uint8_t)0x05U)  /* SPI3/I2S3 Alternate Function mapping   */
#define GPIO_AF5_SPI4          ((uint8_t)0x05U)  /* SPI4 Alternate Function mapping        */
#define GPIO_AF5_SPI5          ((uint8_t)0x05U)  /* SPI5 Alternate Function mapping        */
#define GPIO_AF5_SPI6          ((uint8_t)0x05U)  /* SPI6 Alternate Function mapping        */
#define GPIO_AF5_I2S3ext       ((uint8_t)0x05U)  /* I2S3ext_SD Alternate Function mapping  */

/** 
  * @brief   AF 6 selection  
  */ 
#define GPIO_AF6_SPI3          ((uint8_t)0x06U)  /* SPI3/I2S3 Alternate Function mapping  */
#define GPIO_AF6_I2S2ext       ((uint8_t)0x06U)  /* I2S2ext_SD Alternate Function mapping */
#define GPIO_AF6_SAI1          ((uint8_t)0x06U)  /* SAI1 Alternate Function mapping       */

/** 
  * @brief   AF 7 selection  
  */ 
#define GPIO_AF7_USART1        ((uint8_t)0x07U)  /* USART1 Alternate Function mapping     */
#define GPIO_AF7_USART2        ((uint8_t)0x07U)  /* USART2 Alternate Function mapping     */
#define GPIO_AF7_USART3        ((uint8_t)0x07U)  /* USART3 Alternate Function mapping     */
#define GPIO_AF7_I2S3ext       ((uint8_t)0x07U)  /* I2S3ext_SD Alternate Function mapping */

/** 
  * @brief   AF 8 selection  
  */ 
#define GPIO_AF8_UART4         ((uint8_t)0x08U)  /* UART4 Alternate Function mapping  */
#define GPIO_AF8_UART5         ((uint8_t)0x08U)  /* UART5 Alternate Function mapping  */
#define GPIO_AF8_USART6        ((uint8_t)0x08U)  /* USART6 Alternate Function mapping */
#define GPIO_AF8_UART7         ((uint8_t)0x08U)  /* UART7 Alternate Function mapping  */
#define GPIO_AF8_UART8         ((uint8_t)0x08U)  /* UART8 Alternate Function mapping  */

/** 
  * @brief   AF 9 selection 
  */ 
#define GPIO_AF9_CAN1          ((uint8_t)0x09U)  /* CAN1 Alternate Function mapping    */
#define GPIO_AF9_CAN2          ((uint8_t)0x09U)  /* CAN2 Alternate Function mapping    */
#define GPIO_AF9_TIM12         ((uint8_t)0x09U)  /* TIM12 Alternate Function mapping   */
#define GPIO_AF9_TIM13         ((uint8_t)0x09U)  /* TIM13 Alternate Function mapping   */
#define GPIO_AF9_TIM14         ((uint8_t)0x09U)  /* TIM14 Alternate Function mapping   */
#define GPIO_AF9_LTDC          ((uint8_t)0x09U)  /* LCD-TFT Alternate Function mapping */

/** 
  * @brief   AF 10 selection  
  */ 
#define GPIO_AF10_OTG_FS        ((uint8_t)0x0AU)  /* OTG_FS Alternate Function mapping */
#define GPIO_AF10_OTG_HS        ((uint8_t)0x0AU)  /* OTG_HS Alternate Function mapping */

/** 
  * @brief   AF 11 selection  
  */ 
#define GPIO_AF11_ETH           ((uint8_t)0x0BU)  /* ETHERNET Alternate Function mapping */

/** 
  * @brief   AF 12 selection  
  */ 
#define GPIO_AF12_FMC           ((uint8_t)0x0CU)  /* FMC Alternate Function mapping                      */
#define GPIO_AF12_OTG_HS_FS     ((uint8_t)0x0CU)  /* OTG HS configured in FS, Alternate Function mapping */
#define GPIO_AF12_SDIO          ((uint8_t)0x0CU)  /* SDIO Alternate Function mapping                     */

/** 
  * @brief   AF 13 selection  
  */ 
#define GPIO_AF13_DCMI          ((uint8_t)0x0DU)  /* DCMI Alternate Function mapping */

/** 
  * @brief   AF 14 selection  
  */
#define GPIO_AF14_LTDC          ((uint8_t)0x0EU)  /* LCD-TFT Alternate Function mapping */

/** 
  * @brief   AF 15 selection  
  */ 
#define GPIO_AF15_EVENTOUT      ((uint8_t)0x0FU)  /* EVENTOUT Alternate Function mapping */

class STM32_GPIO
{
public:
    static void init_all();
    inline void init(GPIO_TypeDef* gpio) { m_gpio = gpio; }

    inline uint32_t pin_read(uint32_t pin_mask) { return (m_gpio->IDR & pin_mask); }

    inline void pin_ON(uint32_t pin_mask) { m_gpio->BSRR = pin_mask; }
    inline void pin_OFF(uint32_t pin_mask) { m_gpio->BSRR = (pin_mask << GPIO_BSRR_BR0_Pos); }
    
    void set_config(uint32_t pin_mask, uint32_t pin_mode, uint8_t pin_alt, uint32_t pin_speed, uint32_t pin_pull);
    void unset_config(uint32_t pin_mask);
private:
    GPIO_TypeDef*   m_gpio;
};

extern STM32_GPIO gpioa;
extern STM32_GPIO gpiob;
extern STM32_GPIO gpioc;
extern STM32_GPIO gpiod;
extern STM32_GPIO gpioe;
extern STM32_GPIO gpiof;
extern STM32_GPIO gpiog;
extern STM32_GPIO gpioh;

#endif
