andreili/STM32-PLC/firmware/fw_cpu/platforms/stm32/stm32_uart.cpp

#include "stm32_uart.h"
#include "my_func.h"

#define UART_BRR (F_CPU / BRATE)

#define UART_DISABLE() BIT_BAND_PER(m_uart->CR1, USART_CR1_UE) = 0
#define UART_ENABLE()  BIT_BAND_PER(m_uart->CR1, USART_CR1_UE) = 1

#define UART_STOPBITS_1                     ((uint32_t)0x00000000U)
#define UART_STOPBITS_2                     ((uint32_t)USART_CR2_STOP_1)

#define UART_WORDLENGTH_8B                  ((uint32_t)0x00000000U)
#define UART_WORDLENGTH_9B                  ((uint32_t)USART_CR1_M)

#define UART_PARITY_NONE                    ((uint32_t)0x00000000U)
#define UART_PARITY_EVEN                    ((uint32_t)USART_CR1_PCE)
#define UART_PARITY_ODD                     ((uint32_t)(USART_CR1_PCE | USART_CR1_PS)) 

#define UART_HWCONTROL_NONE                  ((uint32_t)0x00000000U)
#define UART_HWCONTROL_RTS                   ((uint32_t)USART_CR3_RTSE)
#define UART_HWCONTROL_CTS                   ((uint32_t)USART_CR3_CTSE)
#define UART_HWCONTROL_RTS_CTS               ((uint32_t)(USART_CR3_RTSE | USART_CR3_CTSE))

#define UART_MODE_RX                        ((uint32_t)USART_CR1_RE)
#define UART_MODE_TX                        ((uint32_t)USART_CR1_TE)
#define UART_MODE_TX_RX                     ((uint32_t)(USART_CR1_TE |USART_CR1_RE))

#define UART_OVERSAMPLING_16                    ((uint32_t)0x00000000U)
#define UART_OVERSAMPLING_8                     ((uint32_t)USART_CR1_OVER8)

void STM32_UART::init_all()
{
    #ifdef STM32_USE_UART1
    uart1.init_base(USART1);
    #endif
    #ifdef STM32_USE_UART2
    uart2.init_base(USART2);
    #endif
    #ifdef STM32_USE_UART3
    uart3.init_base(USART3);
    #endif
    #ifdef STM32_USE_UART4
    uart4.init_base(UART4);
    #endif
    #ifdef STM32_USE_UART5
    uart5.init_base(UART5);
    #endif
    #ifdef STM32_USE_UART6
    uart6.init_base(USART6);
    #endif
    #ifdef STM32_USE_UART7
    uart7.init_base(UART7);
    #endif
    #ifdef STM32_USE_UART8
    uart8.init_base(UART8);
    #endif
}

void STM32_UART::init_base(USART_TypeDef* uart)
{
    m_uart = uart;
    m_busy = false;
    switch ((uint32_t)m_uart)
    {
    #ifdef STM32_USE_UART1
    case USART1_BASE:
        //RCC->AHB1ENR |= RCC_AHB1ENR_GPIOAEN;
        break;
    #endif
    #ifdef STM32_USE_UART2
    case USART2_BASE:
        break;
    #endif
    #ifdef STM32_USE_UART3
    case USART3_BASE:
        STM32_RCC::enable_clk_GPIOB();
        gpiob.set_config(GPIO_PIN_10|GPIO_PIN_11, GPIO_MODE_AF_PP, GPIO_AF7_USART3, GPIO_SPEED_FREQ_VERY_HIGH, GPIO_PULLUP);
        break;
    #endif
    #ifdef STM32_USE_UART4
    case UART4_BASE:
        break;
    #endif
    #ifdef STM32_USE_UART5
    case UART5_BASE:
        break;
    #endif
    #ifdef STM32_USE_UART6
    case USART6_BASE:
        break;
    #endif
    #ifdef STM32_USE_UART7
    case UART7_BASE:
        break;
    #endif
    #ifdef STM32_USE_UART8
    case UART8_BASE:
        break;
    #endif
    }
}

void STM32_UART::init(uint32_t brate)
{
    // Clock enable
    switch ((uint32_t)m_uart)
    {
    case USART1_BASE:
        BIT_BAND_PER(RCC->APB2ENR, RCC_APB2ENR_USART1EN) = ENABLE;
        break;
    case USART2_BASE:
        BIT_BAND_PER(RCC->APB1ENR, RCC_APB1ENR_USART2EN) = ENABLE;
        break;
    case USART3_BASE:
        BIT_BAND_PER(RCC->APB1ENR, RCC_APB1ENR_USART3EN) = ENABLE;
        break;
    case UART4_BASE:
        BIT_BAND_PER(RCC->APB1ENR, RCC_APB1ENR_UART4EN) = ENABLE;
        break;
    case UART5_BASE:
        BIT_BAND_PER(RCC->APB1ENR, RCC_APB1ENR_UART5EN) = ENABLE;
        break;
    case USART6_BASE:
        BIT_BAND_PER(RCC->APB2ENR, RCC_APB2ENR_USART6EN) = ENABLE;
        break;
    case UART7_BASE:
        BIT_BAND_PER(RCC->APB1ENR, RCC_APB1ENR_UART7EN) = ENABLE;
        break;
    case UART8_BASE:
        BIT_BAND_PER(RCC->APB1ENR, RCC_APB1ENR_UART8EN) = ENABLE;
        break;
    }

    UART_DISABLE();

    set_config();
    set_baud_rate(brate);

    // UART
    m_uart->CR2 &= ~(USART_CR2_LINEN | USART_CR2_CLKEN);
    // USART
    //m_uart->CR2 &= ~(USART_CR2_LINEN);
    m_uart->CR3 &= ~(USART_CR3_SCEN | USART_CR3_HDSEL | USART_CR3_IREN);
    UART_ENABLE();
}

#define UART_DIV_SAMPLING16(_PCLK_, _BAUD_)            (((_PCLK_)*25U)/(4U*(_BAUD_)))
#define UART_DIVMANT_SAMPLING16(_PCLK_, _BAUD_)        (UART_DIV_SAMPLING16((_PCLK_), (_BAUD_))/100U)
#define UART_DIVFRAQ_SAMPLING16(_PCLK_, _BAUD_)        (((UART_DIV_SAMPLING16((_PCLK_), (_BAUD_)) - (UART_DIVMANT_SAMPLING16((_PCLK_), (_BAUD_)) * 100U)) * 16U + 50U) / 100U)
#define UART_BRR_SAMPLING16(_PCLK_, _BAUD_)            (((UART_DIVMANT_SAMPLING16((_PCLK_), (_BAUD_)) << 4U) + \
                                                        (UART_DIVFRAQ_SAMPLING16((_PCLK_), (_BAUD_)) & 0xF0U)) + \
                                                        (UART_DIVFRAQ_SAMPLING16((_PCLK_), (_BAUD_)) & 0x0FU))

void STM32_UART::set_baud_rate(uint32_t brate)
{
    m_brate = brate;
    uint32_t freq;
    if((m_uart == USART1) || (m_uart == USART6))
        freq = STM32_RCC::get_PCLK2_freq();
    else
        freq = STM32_RCC::get_PCLK1_freq();
    m_uart->BRR = UART_BRR_SAMPLING16(freq, brate);
}

void STM32_UART::send_char(char ch)
{
    while (m_busy) {}
    m_busy = true;
    while ((m_uart->SR & USART_SR_TXE) != USART_SR_TXE);
    m_uart->DR = ch;
    m_busy = false;
}

void STM32_UART::send_str(const char *str, TXRX_MODE mode)
{
    while (m_busy) {}
    send_buf(str, strlen(str) + 1, mode);
}

void STM32_UART::send_buf(const char *buf, int size, TXRX_MODE mode)
{
	m_tx_size = size;
    m_tx_pos = 0;

    switch (mode)
    {
    case TXRX_MODE::DIRECT:
        m_busy = true;
        while (m_tx_pos < m_tx_size)
        {
            while ((m_uart->SR & USART_SR_TXE) != USART_SR_TXE);
            m_uart->DR = buf[m_tx_pos++];
        }
        m_busy = false;
        break;
    case TXRX_MODE::INTERRUPT:
        #ifdef STM32_UART_MODE_IT_ENABLE
        m_busy = true;
        memcpy((uint8_t*)m_tx_buf, (uint8_t*)buf, size);
        m_uart->CR1 |= USART_CR1_TXEIE;
        BIT_BAND_PER(m_uart->CR1, USART_CR1_TXEIE) = 1;
        #endif
        break;
    case TXRX_MODE::DMA:
        ///TODO
        #ifdef STM32_UART_MODE_DMA_ENABLE
        #endif
        break;
    }

}

void inline STM32_UART::irq_proc()
{
    if (m_uart->SR & USART_SR_RXNE)
        recv_data();
    else if (m_uart->SR & USART_SR_TXE)
        send_data();
}

void STM32_UART::set_config()
{
    uint32_t tmpreg;
    
    /*-------------------------- USART CR2 Configuration -----------------------*/
    tmpreg = m_uart->CR2;

    /* Clear STOP[13:12] bits */
    tmpreg &= (uint32_t)~((uint32_t)USART_CR2_STOP);

    /* Configure the UART Stop Bits: Set STOP[13:12] bits according to huart->Init.StopBits value */
    tmpreg |= STM32_UART_STOPBITS;

    /* Write to USART CR2 */
    m_uart->CR2 = tmpreg;

    /*-------------------------- USART CR1 Configuration -----------------------*/
    tmpreg = m_uart->CR1;

    /* Clear M, PCE, PS, TE and RE bits */
    tmpreg &= (uint32_t)~((uint32_t)(USART_CR1_M | USART_CR1_PCE | USART_CR1_PS | USART_CR1_TE | \
                            USART_CR1_RE | USART_CR1_OVER8));

    /* Configure the UART Word Length, Parity and mode: 
    Set the M bits according to huart->Init.WordLength value 
    Set PCE and PS bits according to huart->Init.Parity value
    Set TE and RE bits according to huart->Init.Mode value
    Set OVER8 bit according to huart->Init.OverSampling value */
    tmpreg |= STM32_UART_WORDLENGTH | STM32_UART_PARITY | UART_MODE_TX_RX | UART_OVERSAMPLING_16;

    #ifdef STM32_UART_MODE_IT_ENABLE
    tmpreg |= USART_CR1_RXNEIE;
    #endif

    /* Write to USART CR1 */
    m_uart->CR1 = tmpreg;

    /*-------------------------- USART CR3 Configuration -----------------------*/  
    tmpreg = m_uart->CR3;

    /* Clear CTSE and RTSE bits */
    tmpreg &= (uint32_t)~((uint32_t)(USART_CR3_RTSE | USART_CR3_CTSE));

    /* Configure the UART HFC: Set CTSE and RTSE bits according to huart->Init.HwFlowCtl value */
    tmpreg |= UART_HWCONTROL_NONE;

    /* Write to USART CR3 */
    m_uart->CR3 = tmpreg;
}

void STM32_UART::recv_data()
{
    m_rx_buf[m_rx_pos++] = m_uart->DR;
	m_rx_size = m_rx_pos;
}

void STM32_UART::send_data()
{
    m_uart->DR = m_tx_buf[m_tx_pos++];
	if (m_tx_pos >= m_tx_size)
    {
        BIT_BAND_PER(m_uart->CR1, USART_CR1_TXEIE) = 0;
        m_busy = false;
    }
}


#ifdef STM32_UART_MODE_IT_ENABLE
#ifdef STM32_USE_UART1
STM32_UART uart1;

void ISR::USART1_IRQ()
{
	uart1.irq_proc();
}
#endif

#ifdef STM32_USE_UART2
STM32_UART uart2;

void ISR::USART2_IRQ()
{
	uart2.irq_proc();
}
#endif

#ifdef STM32_USE_UART3
STM32_UART uart3;

void ISR::USART3_IRQ()
{
    uart3.irq_proc();
}
#endif

#ifdef STM32_USE_UART4
STM32_UART uart4;

void ISR::UART4_IRQ()
{
	uart4.irq_proc();
}
#endif

#ifdef STM32_USE_UART5
STM32_UART uart5;

void ISR::UART5_IRQ()
{
	uart5.irq_proc();
}
#endif

#ifdef STM32_USE_UART6
STM32_UART uart6;

void ISR::USART6_IRQ()
{
	uart6.irq_proc();
}
#endif

#ifdef STM32_USE_UART7
STM32_UART uart7;

void ISR::UART7_IRQ()
{
	uart7.irq_proc();
}
#endif

#ifdef STM32_USE_UART8
STM32_UART uart8;

void ISR::UART8_IRQ()
{
	uart8.irq_proc();
}
#endif
#endif
