andreili/STM32-PLC/runtime/runtime.h

#ifndef RUNTIME_H
#define RUNTIME_H

#include "settings.h"

class Firmware;
class PLCBus;
struct ModuleInfo;

class Runtime
{
public:
    Runtime();

    void run();
private:
    static  Firmware    m_firmware;
    static  PLCBus      m_bus;

    bool load_firmware();

    void comm_thread();
    void main_thread();
};

#endif // RUNTIME_H
