andreili/STM32-PLC/runtime/settings.h

#ifndef SETTINGS_H
#define SETTINGS_H

#include <inttypes.h>

//#define FPGA_ALLOW

//cycle time settings (in ms)
#define CYCLE_TIME_COMM 100
#define CYCLE_TIME_MMAIN 100

#define BUS_MSG_DATA_SIZE 100
#ifdef FPGA_ALLOW
#define BUS_UART_DEVICE "/dev/ttyAL0"
#else
#define BUS_UART_DEVICE "/dev/ttyUSB0"
#endif
#define BUS_UART_BRATE B9600

#define BUS_MAX_MODULES 1024
#define BUS_MAX_MODULES_ON_RACK 32
#define BUS_WAIT_TIME_MS 50

#define MEM_AREA_SIZE   4096
#define IO_AREA_SIZE 4096

#define RT_ROOT_PATH "./"

#endif // SETTINGS_H
