andreili/STM32-PLC/firmware/fw_cpu/platforms/stm32/stm32_systick.cpp

#include "stm32_inc.h"
#include "plc_io.h"

volatile uint32_t STM32_SYSTICK::m_tick;

void STM32_SYSTICK::init()
{
    update_freq();
    set_clock_source(SYSTICK_CLKSOURCE_HCLK);
    STM32_NVIC::set_priority(SysTick_IRQn, STM32_PRIORITY_SYSCLK, 0);
    m_tick = 0;
}

void STM32_SYSTICK::update_freq()
{
    SysTick_Config(STM32_RCC::get_HCLK_freq() / 1000 - 1);
    set_clock_source(SYSTICK_CLKSOURCE_HCLK);
}

void STM32_SYSTICK::set_clock_source(uint32_t src)
{
    if (src == SYSTICK_CLKSOURCE_HCLK)
        SysTick->CTRL |= SYSTICK_CLKSOURCE_HCLK;
    else
        SysTick->CTRL &= ~SYSTICK_CLKSOURCE_HCLK;
}

void STM32_SYSTICK::on_tick()
{
    ++m_tick;
    PLC_IO::timer_proc();
}

void STM32_SYSTICK::delay(__IO uint32_t delay_ms)
{
    if (m_tick == 0)
        return;
    uint32_t tick_end = m_tick + delay_ms;
    while(m_tick < tick_end) {}
}

void ISR::SysTickTimer()
{
    STM32_SYSTICK::on_tick();
}
