andreili/STM32-PLC/firmware/fw_cpu/platforms/stm32/stm32_nvic.h

#ifndef STM32_NVIC_H
#define STM32_NVIC_H

#include "stm32_conf.h"

#define NVIC_PRIORITYGROUP_0 ((uint32_t)0x07)/*!< 0 bits for pre-emption priority
                                                  4 bits for subpriority */
#define NVIC_PRIORITYGROUP_1 ((uint32_t)0x06)/*!< 1 bits for pre-emption priority
                                                  3 bits for subpriority */
#define NVIC_PRIORITYGROUP_2 ((uint32_t)0x05)/*!< 2 bits for pre-emption priority
                                                  2 bits for subpriority */
#define NVIC_PRIORITYGROUP_3 ((uint32_t)0x04)/*!< 3 bits for pre-emption priority
                                                  1 bits for subpriority */
#define NVIC_PRIORITYGROUP_4 ((uint32_t)0x03)/*!< 4 bits for pre-emption priority
                                                  0 bits for subpriority */

uint32_t _NVIC_EncodePriority (uint32_t PriorityGroup, uint32_t PreemptPriority, uint32_t SubPriority);
uint32_t _NVIC_GetPriorityGrouping(void);

class STM32_NVIC
{
public:
    static void init();
    static void init_vectors();

    static FORCE_INLINE void set_priority_grouping(uint32_t val) { NVIC_SetPriorityGrouping(val); }
    static FORCE_INLINE uint32_t get_priority_grouping() { return _NVIC_GetPriorityGrouping(); }

    static FORCE_INLINE uint32_t encode_priority(uint32_t group, uint32_t pre_prior, uint32_t sub_prior)
            { return NVIC_EncodePriority(group, pre_prior, sub_prior); }

    static FORCE_INLINE void set_priority(IRQn_Type irqn, uint32_t val) { NVIC_SetPriority(irqn, val); }
    static FORCE_INLINE void set_priority(IRQn_Type irqn, uint32_t prior, uint32_t subprior)
            { NVIC_SetPriority(irqn,
                               _NVIC_EncodePriority(get_priority_grouping(),
                                                   prior, subprior)); }
    static inline void enable_IRQ(IRQn_Type irqn) { NVIC_EnableIRQ(irqn); }
    static inline void disable_IRQ(IRQn_Type irqn) { NVIC_DisableIRQ(irqn); }
    static inline void enable_and_set_prior_IRQ(IRQn_Type irqn, uint32_t prior, uint32_t subprior)
            { set_priority(irqn, prior, subprior);
              enable_IRQ(irqn); }
};

#endif // STM32_NVIC_H
