andreili/STM32-PLC/firmware/fw_di16/inc/plc_mod_info.h

const plc_mod_info_t mod_info = {type: PLC_MOD_TYPE_DI,
                                hw_version: 1,
                                fw_version: 1,
                                inputs: 16,
                                outputs: 0};
