andreili/STM32-PLC/firmware/fw_cpu/platforms/stm32/stm32_flash.cpp

#include "stm32_flash.h"

void STM32_FLASH::instruction_cache_reset()
{
    FLASH->ACR |= FLASH_ACR_ICRST;
    FLASH->ACR &= ~FLASH_ACR_ICRST;
}

void STM32_FLASH::data_cache_reset()
{
    FLASH->ACR |= FLASH_ACR_DCRST;
    FLASH->ACR &= ~FLASH_ACR_DCRST;
}
