andreili/STM32-PLC/runtime/firmware_sample/firmware.cpp

#include "firmware.h"
#include "fwdb.h"
#include <iostream>
#include "plcstate.h"
#include "plcdata.h"

#define proc_none() (true)

#define run_OB10()  proc_none()
#define run_OB11()  proc_none()
#define run_OB12()  proc_none()
#define run_OB13()  proc_none()
#define run_OB14()  proc_none()
#define run_OB15()  proc_none()
#define run_OB16()  proc_none()
#define run_OB17()  proc_none()
#define run_OB20()  proc_none()
#define run_OB21()  proc_none()
#define run_OB22()  proc_none()
#define run_OB23()  proc_none()
#define run_OB30()  proc_none()
#define run_OB30()  proc_none()
#define run_OB31()  proc_none()
#define run_OB32()  proc_none()
#define run_OB33()  proc_none()
#define run_OB34()  proc_none()
#define run_OB35()  proc_none()
#define run_OB36()  proc_none()
#define run_OB37()  proc_none()
#define run_OB38()  proc_none()
#define run_OB40()  proc_none()
#define run_OB41()  proc_none()
#define run_OB42()  proc_none()
#define run_OB43()  proc_none()
#define run_OB44()  proc_none()
#define run_OB45()  proc_none()
#define run_OB46()  proc_none()
#define run_OB47()  proc_none()
#define run_OB48()  proc_none()
#define run_OB60()  proc_none()
#define run_OB80()  proc_none()
#define run_OB81()  proc_none()
#define run_OB82()  proc_none()
#define run_OB83()  proc_none()
#define run_OB85()  proc_none()
#define run_OB86()  proc_none()
#define run_OB87()  proc_none()
#define run_OB90()  proc_none()
#define run_OB100() proc_none()
#define run_OB101() proc_none()
#define run_OB102() proc_none()
#define run_OB121() proc_none()
#define run_OB122() proc_none()

Firmware::Firmware()
{}

bool Firmware::init()
{
    //TODO: reset FW state

    FWDB::read();

    return true;
}
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
