andreili/STM32-PLC/(commit log)

2017-07-19 Исправлено имя класса STM32_SYSTICK
    [init.cpp, plc_io.cpp, stm32_systick.cpp, stm32_systick.h]
2017-07-19 Исправлены имена методов в STM32_RCC
    [plc_io.cpp, stm32_gpio.cpp, stm32_rcc.cpp, stm32_rcc.h, stm32_uart.cpp]
2017-07-19 Реализован базовый функционал STM32_PWR (только из HAL_PWR_EX)
2017-07-20 Дописан класс STM32_RCC
2017-07-20 Исправлен класс STM32_FLASH
2017-07-20 Завершен класс STM32_PWR
2017-07-20 Завершен класс STM32_SYSTICK
2017-07-21 Исправлена оптимизация переменной таймера
    [stm32_systick.cpp, stm32_systick.h]
2017-07-21 Добавлена реализация xprintf
2017-07-21 Добавлена инициализация SDRAM
2017-07-21 Исправлена частота обновления памяти и добавлено тестирование памяти
    [init.cpp, my_func.cpp, my_func.h, plc_io.cpp, stm32_conf.h, stm32_rcc.cpp, stm32_sdram.cpp, stm32_sdram.h]
2017-07-21 Добавлен класс для управления состоянием PLC
2017-07-21 Добавлено состояние "инициализация" и исправлена индикация режимов работы PLC.
    [init.cpp, main.cpp, plc_control.cpp, plc_control.h, plc_io.cpp]
2017-07-22 Добавлена инициализация стека
2017-07-23 Включение кэширования и буфера сделаны опциональными
2017-07-23 Добавлен класс STM32_NVIC
2017-07-23 Инициализация UART разбита на 2 этапа
2017-07-23 Исправлена очередность инициализации
2017-07-23 Все требуевые включения файлов вынесены в отдельный заголовочный файл
2017-07-23 Вывод текста перенесен в main.cpp
2017-07-23 Убрана очистка памяти при сбросе контроллера
2017-07-23 Оптимизирован код класса STM32_UART
2017-07-24 Оптимизировано управление индикацией состояния PLC
2017-07-24 Обновлен код класса STM32_UART
2017-07-24 Обновлен код инициализации и обработки прерываний
2017-07-24 Исправлена опечатка в инициализации GPIO
    [stm32_gpio.cpp]
2017-07-24 исправлена инициализация и работа UART
    [init.cpp, stm32_conf.h, stm32_gpio.cpp, stm32_uart.cpp, stm32_uart.h]
2017-07-24 Добавлена инициализация векторов прерываний для переферии
2017-07-24 Вывод текстовых сообщений вынесен в класс PLC_CONTROL
2017-07-25 Обновлена инициализация SDRAM
2017-07-26 Время выполнения команд SDRAM вынесено в константу
2017-07-26 Обновлен код инициализации SysTick
2017-07-26 Завершена отладка инициализации памяти
2017-07-26 Исправлено зависание при отправке данных в UART
    [stm32_uart.cpp, stm32_uart.h]
2017-07-26 Добавлена инициализация FPU
2017-07-26 Оптимизация системных функций по скорости
2017-07-26 Добавлен тест скорости памяти
2017-07-26 Исправлена опечатка
2017-07-26 Обновлен вывод информации
2017-07-26 Добавлена FPU-libc для линковки
2017-07-26 Увеличена тактовая частота
2017-07-26 Убраны "волшебные числа"
2017-07-28 Добавлена начальная поддержка FatFS
2017-08-01 Добавлен черновой вариант класса STM32_SPI
2017-08-03 Бибилотеки перенесены в общий каталог проекта. Добавлена поддрежка STM32F1xx
2017-08-03 Добавлена инициализация модулей PLC
2017-08-03 Добавлен код для STM32F1xx
2017-08-03 Добавлен проект модуля DI
2017-08-03 Исправлена инициализация RCC
2017-08-03 Исправлен расчет стека и расположение GOT для STM32F1xx
2017-08-03 Добавлена начальная поддержка модулей в CPU
2017-08-03 Добавлены общие файлы для прошивок модулей
2017-08-03 Добавлен базовый проект модуля DI16
2017-08-03 Добавлена последовательность инициализации модуля
2017-08-03 Перемещены оставшиеся общие файлы
2017-08-04 Шина EXT-MOD переведена на аппаратный сигнал NSS
2017-08-04 MOD: Добавлена обработка входов/выходов шины
2017-08-06 Оптимизация инициализации модуля по скорости
2017-08-07 Добавлена черновая схема модуля DI16
    [module_di.sch]
2017-08-08 Обновлена схема модуля DI16
    [module_di.kicad_pcb, module_di.sch]
2017-08-08 Обработка NSS модуля переведена в аппаратный режим
2017-08-08 Добавлена схема модуля CPU
    [hw_cpu.kicad_pcb, hw_cpu.sch]
2017-08-09 Обновлена схема CPU
    [hw_cpu.kicad_pcb, hw_cpu.sch]
2017-08-09 Обновлена плата CPU
    [hw_cpu.kicad_pcb]
2017-08-11 Обновлены схема и плата CPU.
    Добавлены переключатель START/STOP, кнопки DUMP и RESTORE.
    [hw_cpu.kicad_pcb, hw_cpu.sch]
2017-08-11 Добавлен список TODO
2017-08-13 Обновлена плата CPU.
    Завершена предварительная трассировка
    [hw_cpu.kicad_pcb, hw_cpu.sch]
2017-08-13 Обновлена плата CPU.
    Исправлен шелк для батарейки
    [hw_cpu.kicad_pcb]
2017-08-14 Обновлена плата CPU.
    [hw_cpu.kicad_pcb]
2017-08-16 Обновлена плата CPU.
    Добавлены размеры
    [hw_cpu.kicad_pcb]
2017-08-16 Обновлена плата DI16.
    Завершена предварительная разводка.
    [module_di.kicad_pcb, module_di.sch]
2017-08-16 Добавлена кросс-плата для соединения модулей.
    [cross.kicad_pcb, cross.sch]
2017-08-16 Добавлена плата для соединения модуля с кросс-модулем
    [mod_cross.kicad_pcb, mod_cross.sch]
2017-08-16 Добавлена предварительная версия платы модуля DO16.
    [module_do.kicad_pcb, module_do.sch]
2017-08-18 Обновлена плата модуля DI16.
    Добавлены статусные светодиоды.
    [module_di.kicad_pcb, module_di.sch]
2017-08-18 Обновлена плата модуля DO16.
    Завершена предварительная трассировка.
    [module_do.kicad_pcb, module_do.sch]
2017-08-18 Обновлена кросс-плата для модулей.
    [mod_cross.kicad_pcb]
2017-08-18 Обновлена шелкография на платах.
    [hw_cpu.kicad_pcb, module_di.kicad_pcb, module_di.sch, module_do.kicad_pcb]
2017-08-22 Обновлена плата кросс-модуля.
    Добавлена буферизация шины.
    [cross.kicad_pcb, cross.sch]
2017-08-22 Обновлены платы модулей - приведены к единому виду.
    [cross.kicad_pcb, hw_cpu.kicad_pcb, mod_cross.kicad_pcb, module_di.kicad_pcb, module_di.sch, module_do.kicad_pcb, module_do.sch]
2017-08-23 Обновлены платы модулей.
    Добавлен разъем для работы с аппаратным загрузчиком.
    [module_di.kicad_pcb, module_di.sch, module_do.kicad_pcb, module_do.sch]
2017-09-01 Добавлен отладочный вывод монтирования SD-карты
2017-09-01 Обновлены платы модулей
    [cross.kicad_pcb, hw_cpu.kicad_pcb, mod_cross.kicad_pcb, module_di.kicad_pcb, module_do.kicad_pcb]
2017-09-01 Исправлено расположение файлов проекта
    [stm32_conf.h, stm32_flash.cpp, stm32_flash.h, stm32_gpio.cpp, stm32_gpio.h, stm32_inc.h, stm32_nvic.cpp, stm32_nvic.h]
2017-09-20 Firmware: Убраны блоки кода для STM32F1xx
2017-09-20 Firmware: Удалены дубликаты общих файлов.
2017-09-20 Firmware: Исправлены опечатки в коде.
    [stm32_rcc.cpp]
2017-09-20 Обновлено до последней версии платы.
2017-09-21 Обновлен код обработки состояний PLC
2017-09-21 Обновлена работа с SD-картой
2017-09-21 Исправлена ошибка инициализации SD-карты.
    [main.cpp, stm32_conf.h, stm32_sd.cpp]
2017-09-22 STM32_SD: Добавлены недостающие функции
2017-09-22 Добавлена обработка записи на SD карту
2017-09-22 Исправлено назначение вывода CARD_DETECT
    [stm32_conf.h]
2017-09-22 Перемещено тело функции Error_Handler
    [plc_control.cpp, plc_io.cpp, stm32_inc.h]
2017-09-22 Добавлен черновой класс STM32_RTC
2017-09-23 Исправлена инициализация RTC
2017-09-23 Исправлена инициализация тактирования
2017-09-23 Процедуры инициализации и главный цикл перенесены в класс PLC_CONTROL
2017-09-23 Оптимизация инициализации
2017-09-23 Исправлена заморозка регистров RTC при чтении из RTC->SSR
    [plc_control.cpp, stm32_rtc.cpp]
2017-09-23 Обновлена работа со статусными полями ПЛК
2017-09-23 Добавлен класс PLC_STATE
2017-09-23 Добавлен расчет времени цикла
2017-09-24 Оптимизация кода RTC
2017-09-24 Время цикла рассчитывается как среднее между 10 циклами
2017-09-24 Добавлен вывод времени цикла
2017-10-27 Адаптация прошивки для 2-х платформ
2017-10-27 Добавлена обработка программы STL.
2017-10-29 Исправлены загрузка и выполнение прошивки.
    [plc_conf.h, plc_control.cpp, plc_data_types.h, plc_fw.cpp, plc_fw.h, plc_platform.cpp, stl_commands.cpp, stl_commands.h]
2017-10-29 Начало реализации компилятора ST(L) .
2017-10-29 STLC: Первичная реализация парсинга.
2017-10-29 STLC: Добавлены тестовые листинги.
    [prog.stl, test.stl]
2017-10-30 STLC: Оптимизация кода.
2017-10-30 STLC: Реализован базовый парсинг STL.
2017-12-08 Добавлен базовый runtime, требуется проверка на устройстве.
2017-12-26 HW: Обновлена схема CPU.
    [hw_cpu.sch]
2017-12-27 HW: Обновлена схема CPU
    [hw_cpu.kicad_pcb, hw_cpu.sch]
2017-12-27 Runtime: Адаптация под SoftPLC (включая FPGA DE1-SoC).
2017-12-29 Runtime: Обновлена обработка модулей на шине.
2017-12-29 Runtime: Исправлена обработка ошибок загрузки.
    [runtime.cpp, settings.h]
2017-12-29 Runtime: Добавлена обработка ошибок модулей.
2018-01-03 Runtime: Переведено на конечный автомат состояний PLC.
2018-01-03 Runtime: Убрано динамическое выделение памяти под объекты.
2018-01-03 Runtime: Добавлены заготовки блоков OB.
2018-01-03 Runtime: Добавлены зарезервированные переходы между состояниями PLC.
2018-01-03 Runtime: Обработка ошибки выполнения программы вынесена в OB84.
2018-01-03 Runtime: Исправлено подключение заголовков для FPGA.
    [plcstate.cpp]
2018-01-03 Runtime: Загрузка сведений о модулях перенесена в класс PLCBus.
2018-01-03 Runtime: Добавлено чтение Profibus и Profinet аресов модулей.
2018-01-04 Runtime: Унификация интерфейсов обращения к данным.
2018-01-05 Runtime: Обработка данных в памяти сведена к единому интерфейсу.
2018-01-05 Runtime: В примере прошивки реализован алгоритм с самоподхватом.
2018-01-05 Runtime: Исправлен пропуск чтения/записи входов/выходов.
    [plcbus.cpp]
2018-01-05 Runtime: Реализовано вычисление времени цикла.
2018-01-05 Runtime: Различные процессы разнесены по потокам со своим минимальным временем цикла.
