andreili/STM32-PLC/(notices)

Notices in the files:
firmware/fw_di16/inc/main.h:
(C) COPYRIGHT STMicroelectronics *****END OF FILE
